tilak-pentapati/Low-Gravity_Rotary-Percussive_Bite-Drilling_System/docs/assets/renders/bit_closeup.png

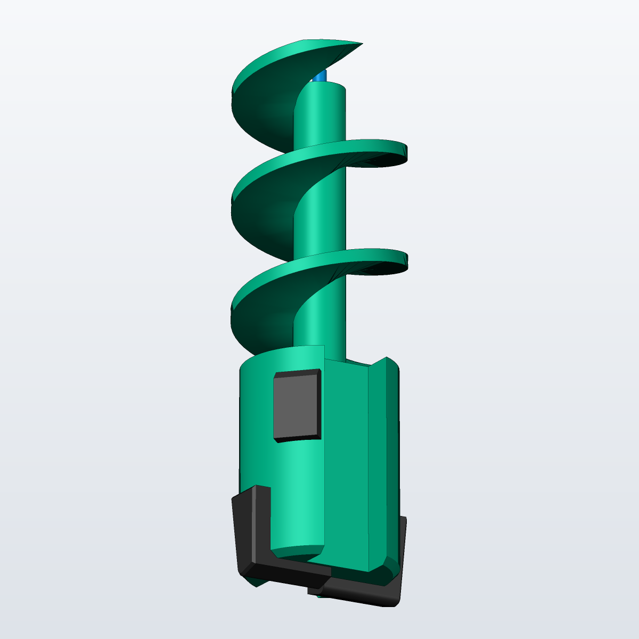
docs/assets/renders/bit_closeup.png
