tilak-pentapati/Low-Gravity_Rotary-Percussive_Bite-Drilling_System/docs/assets/renders/brush_exploded.png

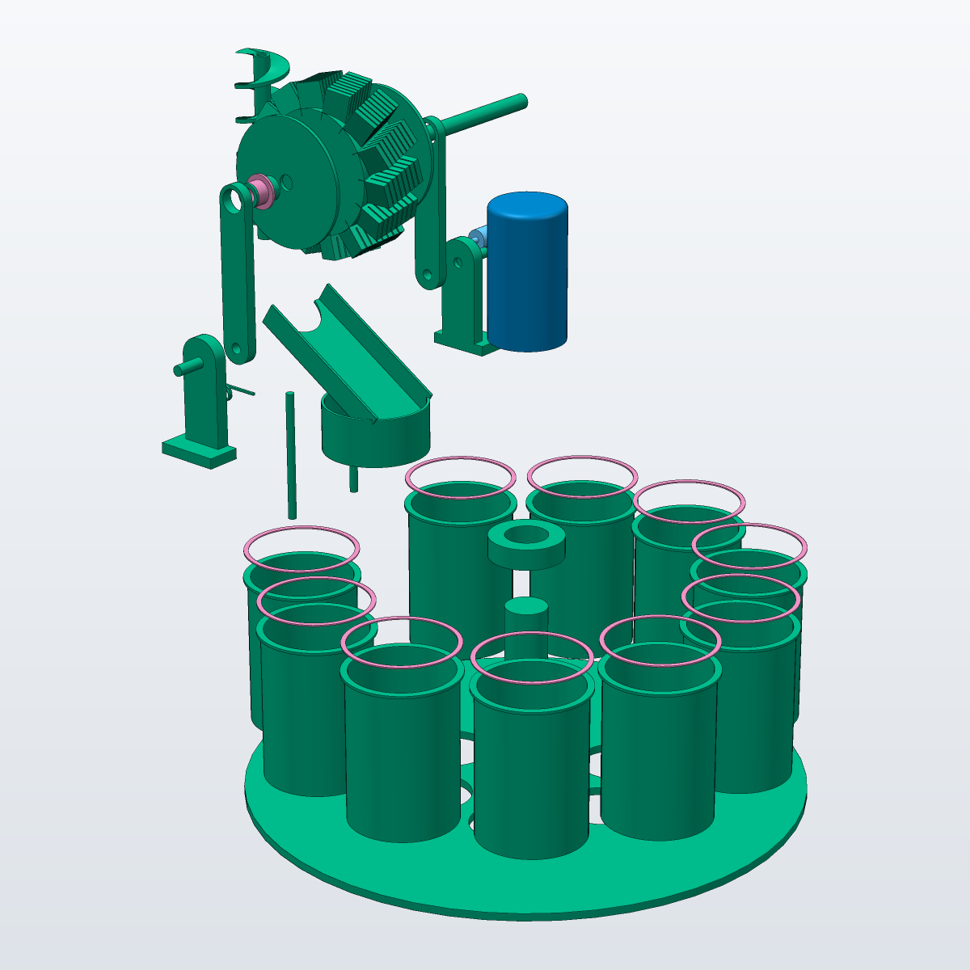
docs/assets/renders/brush_exploded.png
