tilak-pentapati/Low-Gravity_Rotary-Percussive_Bite-Drilling_System/docs/cad_architecture.html

# 3D CAD Architecture & Subassembly Breakdown

Parametric boundary-representation (B-rep) solids, sized by the physics-based design derivations and made interactive in the browser through WebGL, a JavaScript graphics API

Each component on this page is a solid model generated from the system’s design parameters, not drawn by hand. Its dimensions come from the physics-based sizing (loads, stresses, fatigue, vibration and thermal limits), and the browser shows the result as an interactive 3D model.

A boundary representation (B-rep) describes a solid by the surfaces that enclose it. It stores the faces (pieces of planes, cylinders, cones, tori or NURBS surfaces), the edges where faces meet and the vertices where edges meet, together with the topology that records which face borders which [1–3]. Because the boundary is exact, a bearing bore is a true cylinder of a known diameter, and volume, mass, centre of gravity and moments of inertia follow directly from the geometry. A B-rep model is parametric when every dimension is an expression of named inputs, such as auger diameter, flight pitch, bearing size or mast section, instead of a fixed number [4]. When a derivation changes a value (for example the flute depth set by the fatigue check), the solids rebuild with the new value and every dependent dimension follows.

An application programming interface (API) is the set of functions that one piece of software publishes so that other programs can use it. WebGL is such an interface: a JavaScript API, standardised by the Khronos Group, through which a web page sends triangles, material colours and lights to the computer’s graphics processor (GPU) [5]. The viewers on this page use it to draw each model at interactive frame rates in any modern browser, with no plug-in.

The models are published in three file formats, each suited to a different task:

- STEP (ISO 10303-21) is the neutral exchange format for engineering CAD [6]. It carries the exact B-rep geometry, the assembly tree, part names and colours, and it opens in any major CAD package for further design, analysis or manufacture.
- STL stores only a list of flat triangles and their normals, with no units, colours or assembly structure [7]. It is the usual input for 3D printing and for many meshing tools.
- glTF (GL Transmission Format) is the Khronos format for delivering 3D scenes to real-time renderers, and GLB is its single-file binary form [8]. It holds triangle meshes, physically based material properties and a hierarchy of nodes, and it is the format the viewers below load.

## 1 Modelling approach

Every part is modelled once as a parametric B-rep solid by the CAD generator, sized from the same parameter set and design derivations used in the sizing calculations. The same solids are written to colour-labelled, assembly-structured STEP files (mm), tessellated to STL (mm), and tessellated to glTF .glb (m, Y-up) for the viewers below. The web models and the engineering STEP files therefore always match.

Tessellation. The STEP file keeps the exact curved surfaces, but a GPU or a 3D printer can only process flat triangles. Tessellation replaces each curved face by a mesh of triangles whose vertices lie on the true surface, so each triangle edge is a chord across the curve. The error is the chordal deviation, the largest gap between a triangle and the surface it replaces. For a face of radius r divided into segments that each span an angle \theta:

\delta = r\left(1 - \cos\frac{\theta}{2}\right)

- \delta: chordal deviation, the largest distance between the true surface and the triangle that replaces it (mm)
- r: local radius of curvature of the face (mm)
- \theta: angle one segment spans at the centre of curvature (rad)

The generator holds \delta \le 0.08 mm and \theta \le 0.25 rad. On the 10 mm radius of the auger flight, the deviation limit alone would allow \theta = 0.253 rad, so the angular limit governs and a full circle becomes 26 segments. The worst-case error is 0.8 % of the radius, below what a screen can show and below ordinary machining tolerances. Thin, repeated features (helical flights, bristle tufts, coil springs) use coarser limits to keep the files small. The web copy is also converted to the glTF convention of metres with +Y up [8]: a CAD point (x, y, z) in millimetres with Z up becomes (x,\ z,\ -y)\times10^{-3} m. That is a rotation of -90^\circ about the x-axis followed by a scale, so the frame stays right-handed and lengths, angles and the hand of every helix are preserved.

Home pose. The rig is drawn at 1:1 scale in its home pose, the reference configuration from which every motion is measured. In robot-kinematics terms it is the zero position of the prismatic feed joint [9]. The carriage sits at the top of its travel on the rails, so the drill string is fully withdrawn and the bit tip hangs 300 mm above the regolith. That height clears the mast foot plate (100 mm) and the top of the brush (about 223 mm), so the parked bit touches neither the brushing station nor the ground and the load cell reads no weight on bit. To reach the 1.0 m target depth the carriage therefore needs a stroke of 0.30 + 1.00 = 1.30 m. A mission starts and ends here: the controller leaves home, approaches at 5 mm/s until the load cell detects 5 N of contact, and returns to home after the last bite. The digital twin moves the carriage by the displacement \Delta z = z_\text{tip} - z_\text{home} from this pose.

- \Delta z: carriage displacement from the home pose, positive upward (m)
- z_\text{tip}: bit-tip height above the regolith surface at the current instant, negative once the bit is in the hole (m)
- z_\text{home}: bit-tip height in the home pose, 0.30 m

Colour code. The colours carry engineering meaning. Each part is coloured by the job it does in the machine, so a load or energy path can be traced by eye, as in the cutaway drawings of engineering manuals. Finishes are matte, in the manner of technical illustration, so that hue rather than mirror-like highlights carries the information [10]. The eight function hues are the Okabe–Ito colour-universal-design set, chosen so the classes stay distinguishable for readers with colour-vision deficiency, about one man in twelve [11, 12]. Two neutral greys mark the primary structure and the lander. The same colours are written into the STEP part labels, so the code carries into any CAD package.

Colour | Function class | Parts and role
| Rock-cutting interface | Tungsten-carbide inserts and gauge pads: the only parts that touch intact rock
| Seals, bushings & dust control | PTFE / Vespel sliding contacts, lip seals, labyrinths, bellows and wipers that keep regolith out
| Electromechanical conversion & sensing | BLDC motors, encoders, slip ring, load cell, thermocouple path and solar cells
| Percussive (impact) path | Barrel cam, followers, hammer, spring and anvil: stores and releases the blow energy
| Deployment & launch restraint | Hinge, latch, hold-down and release hardware that only works before drilling
| Drill string & sample path | Every part that carries or touches the regolith sample: bit body, auger, brush, chute, cups
| Rotary & linear drive train | Gears, spindle, shafts, bearings, leadscrew, nut and rails that transmit torque and feed force
| Thermal control & energy storage | Avionics warm box, radiator and H2/O2 reactant tanks
| Lander interface (context) | Deck section, legs and footpads that the drill reacts against
| Primary structure | Housings, mast spine, plates, brackets, frames and clamps that carry the loads

Read together, the classes follow the energy through the machine: electrical power is converted in the motors (blue), carried as torque and feed force through the drive train (orange) or stored and released as impact in the percussion path (vermillion), delivered to the rock by the carbide (black), and the reactions return to the lander through the structure (greys). A part’s class follows its role, not its material: the bronze leadscrew nut is orange because it transmits feed force, while the bronze chute is green because it carries the sample.

In every viewer below, drag to orbit, scroll to zoom and right-drag to pan. The tag under each title gives the part count and the overall envelope (width × depth × height). The Download menu offers each model in the three file formats.

### 1.1 Drill bit

#### Crown, sampling sub & joint

11 parts · envelope 21 × 20 × 273 mm

Download

STEPexact B-rep, assembly tree, mmSTLtriangle mesh, mmglTF binary (.glb)web mesh with materials, m

Model failed to load. Serve the site over HTTP; browsers block .glb files opened directly from disk.

#### Exploded view

11 parts · envelope 55 × 42 × 176 mm

Download

STEPexact B-rep, assembly tree, mmSTLtriangle mesh, mmglTF binary (.glb)web mesh with materials, m

Model failed to load. Serve the site over HTTP; browsers block .glb files opened directly from disk.

- Cutters: two WC-10Co chisel inserts, -10° rake / 15° clearance (wedge 85°), edges on the line through the axis so the centre is cut, 2 mm proud of the face. Edge radius 1.00 mm from Hertz contact: carbide FOS 2.08 on a basalt clast, yet 36× the strength of the hardest ice.
- Junk slots: two 8 mm slots ahead of each rake face, sized so their area equals the sampling-flute channel (never the bottleneck). Carbide gauge pads with back-reaming chamfers on the trailing quadrants.
- Indexing: the bit turns 34.6° between hammer blows, so each blow lands 6.3 mm from the last crater at the gauge.
- Sensing & joint: thermocouple pocket ends 0.5 mm above the inserts (carbide conducts the edge heat). M12×1 right-hand joint: drilling torque tightens it, and impact passes through the shoulder (62 MPa), not the thread.
- Exploded view: inserts, gauge pads, thermocouple probe, crown body, sampling sub and coupling pulled apart to show how the bit is built and brazed.

### 1.2 Dual-zone auger string

#### Auger string, bit to hex drive

19 parts · envelope 30 × 20 × 1280 mm

Download

STEPexact B-rep, assembly tree, mmSTLtriangle mesh, mmglTF binary (.glb)web mesh with materials, m

Model failed to load. Serve the site over HTTP; browsers block .glb files opened directly from disk.

- Flights: 20 mm OD over the full length. The upper transport flight runs on a 14/12 mm hollow tube at 39.0 mm pitch (36.1° helix, the screw-efficiency optimum 45° − φ/2).
- Flight attachment: the root carries the stall plug pressure (3.5 MPa, 65 MPa bending) plus an inertial load at every blow's stress-wave front (136 MPa, 3.7e+07 cycles). Fillet welds are strong enough statically, but the weld toe would last only 2.0e+05 cycles (IIW FAT 63), so the flight is machined integral with the tube with a root fillet of t/2: Goodman FOS 2.21.
- String dynamics: a beam model of the 1240 mm string (sampling root, joint, tube, hex) gives a first lateral mode of 46 Hz at the start of the hole (1.77× the blow rate). Without the mast-foot guide bushing (22 mm Vespel liner) it would be 19 Hz, inside the ±20 % resonance band. Buckling 3,294 N vs a 167 N lift-off WOB; first torsional mode 393 Hz; wind-up 13.2° at 6.5 N·m, mostly in the 6 mm sampling root.
- Drive interface: a 16 mm hex sits 52 mm deep in the anvil socket (flank pressure 3.5 MPa, torsion 13 MPa, impact 47 MPa at the pin section). The tube is brazed into the collar (3 mm lap, FOS 19) and its end bears on the socket floor, so the blow never loads the braze. A cross pin (35 MPa at the load-cell rating) carries the hanging string.
- Thermocouple path: a 1 mm type-T lead runs from the bit probe through a spring-loaded coaxial contact at the bit joint (so the bit screws on without twisting it), up the tube and the chamfered hex bore to the slip ring; it fills 6 % of the narrowest bore.

### 1.3 Rotary-percussive drill head

#### Enclosed drill head

68 parts · envelope 220 × 177 × 339 mm

Download

STEPexact B-rep, assembly tree, mmSTLtriangle mesh, mmglTF binary (.glb)web mesh with materials, m

Model failed to load. Serve the site over HTTP; browsers block .glb files opened directly from disk.

#### Quarter section

68 parts · envelope 220 × 177 × 339 mm

Download

STEPexact B-rep, assembly tree, mmSTLtriangle mesh, mmglTF binary (.glb)web mesh with materials, m

Model failed to load. Serve the site over HTTP; browsers block .glb files opened directly from disk.

- Rotary drive: frameless BLDC sized from the 6.5 N·m spindle limit: 0.46 N·m at the rotor gives a Ø31 mm rotor in a Ø54 mm stator. It drives an 8:1 planetary (12/36/84 teeth, 3 planets, module 0.5) and a 12T/24T spur stage (module 1.25). Bending stress is 123 MPa and contact stress 923 MPa, both within AGMA limits for carburised 9310.
- Percussion: a second BLDC drives a 54T ring gear on a two-lobe barrel cam. The cycloidal rise lasts 150°, followed by a 30° dwell, twice the 2.7 ms the hammer takes to fall. The pressure angle peaks at 8.7° and roller contact stress at 528 MPa. The spring is the thinnest stock wire that passes every check: 6.0 mm wire, 3.14 active coils, 360 MPa, fatigue FOS 1.55, surge 682 Hz.
- Load paths: the hammer and anvil both slide on a DIN 5480 spline (flank pressure 4.6 MPa). The 5.4 kN blow travels from hammer to anvil to hex shank and never crosses a bearing. Weight on bit takes a different route: nut, yoke, a 500 N load cell (error 1.2 N, well under the 5 N contact threshold), the housing, the 7004 ACD pair, and the spindle end face. The Tr16×4 screw is self-locking.
- Bearings (SKF catalogue): 7004 ACD pair L10 = 104,061 h, 61804 35,847 h, 61812 cam bearing 18,528 h. The requirement is 400 h, 4× the drilling time. Dust: labyrinth and PTFE lip seal at the spindle exit, a stationary bellows over the 4 mm anvil float, and rail wipers on the LM16UU bushings.
- Quarter section: the housing and the coaxial stack are cut away in one quadrant. From the bottom up: anvil with hex socket, hammer with follower rollers on the barrel cam, spring, 7004 bearing pair, slip ring, 61804 bearing, 24T gear, then the planetary and motor in the offset pod, the load cell and the yoke.

### 1.4 Deployable mast and lander interface

#### Deployed, on the lander deck

118 parts · envelope 1260 × 2249 × 1977 mm

Download

STEPexact B-rep, assembly tree, mmSTLtriangle mesh, mmglTF binary (.glb)web mesh with materials, m

Model failed to load. Serve the site over HTTP; browsers block .glb files opened directly from disk.

#### Launch configuration (stowed)

205 parts · envelope 1260 × 2696 × 884 mm

Download

STEPexact B-rep, assembly tree, mmSTLtriangle mesh, mmglTF binary (.glb)web mesh with materials, m

Model failed to load. Serve the site over HTTP; browsers block .glb files opened directly from disk.

- Architecture: the drill rides on the fore edge of a 0.6 × 1.5 m lander deck section. It launches folded aft over the deck; a strain-wave hinge actuator swings it 90° to vertical, where spring latch pins on two deck posts lock it 250 mm above the hinge. Sequence: SMA hold-down release → carriage to home → deploy → latch → release the brush arm.
- Spine: 80×80×3 mm 6061-T6 Al box, the lightest of 240 (material, section, bracket count, latch height) combinations that passes every check (64 pass the deployed ones). Deployed first mode 20.0–21.2 Hz over the drilling stroke: between the cam (13 Hz) and blow (26 Hz) bands with ≥20% separation, 2% from the nearest band edge. Spine 5.4 kg, rotating assembly 24.9 kg incl. 20% growth allowance. The spine is in tension while drilling; buckling matters only when pulling a stuck string (FOS 218).
- Rails & alignment: 4 brackets support the Ø16 rails every 357 mm; their necks pass the slot of open LM16UU-OP bushings. An end-supported rail would be a 10 Hz string at launch. Under the 167 N lift-off WOB plus a 619 N single-cutter side load, spine bending, slope and rail flex move the string 0.49 mm off the guide-bushing axis (clearance 0.5 mm): a 3.7 mm bit alignment error at 1 m.
- Leadscrew: buckling 2,005 N on the compression side (FOS 12); whirl critical speed 558 rpm, with retraction at 34% of it (limit 80 %). The self-locking Tr16×4 nut holds the carriage at launch (3.5 MPa).
- Hinge, latch & actuator: Ø6 mm 17-4PH pins in double shear at a 14.5 kN launch lug load (FOS 2.4). Deploying needs 53 N·m against Mars gravity with the mast horizontal. ECSS motorisation (2× gravity, friction and harness + 1.25× inertia) gives 108 N·m, a Ø48 mm rotor through a 100:1 strain-wave gear. Earth tests need a g-offload. The latch is sized by stiffness (647 N per pin).
- Lander tilt: a side-mounted drill pushes up 0.35 m from the lander CG, so the near legs unload at 0.82 m g, before the lander lifts. The set-point stays m g / 1.4. The far legs sit 1.94 m behind the drill so the tilt limit (60 N Moon, 137 N Mars) stays above the set-point plus the load-cell error. The tilt margin is 1.15, against 1.4 for a drill through the CG. Footpad friction alone reacts the torque limit (FOS 2.4 on the Moon), so no regolith anchors are needed.
- Stow pose: the carriage parks 701 mm below home, chosen to maximise the weakest local mode. The nut then splits the leadscrew (22 Hz) and the guide bushing props the string (23 Hz); left at home both would be ~10 Hz. At 15 g (GEVS Miles 3σ) the screw sees 124 MPa and the string 200 MPa.
- Stowed primary mode: 97 Hz on the hinge plus 2 hold-downs (requirement 50 Hz; a single hold-down at the crosshead would give 45 Hz with this spine). Launch loads are the larger of 15 g quasi-static and the Miles 3σ response; spine stress 47 MPa (yield FOS 5.1).
- Hold-downs: pyro-free SMA-released A-286 M8 frangible bolts in cup-cone pedestals. They carry 6.6 kN at launch, and the preload keeps the joint closed with NASA-STD-5020 separation and ultimate factors. The cones carry shear, the hinge carries load along the mast, and the actuator gearbox carries none.

### 1.5 Brushing station and sample carousel

#### Brushing station, exploded

60 parts · envelope 210 × 239 × 255 mm

Download

STEPexact B-rep, assembly tree, mmSTLtriangle mesh, mmglTF binary (.glb)web mesh with materials, m

Model failed to load. Serve the site over HTTP; browsers block .glb files opened directly from disk.

- Brush as a worm wheel: the sampling flight is a single-start worm, and the 14 bristle tufts are the wheel teeth on a 29.0 mm pitch radius (35.5 mm from the auger axis), leaning 17.7° at the flight lead. The tuft count is the smallest that enters and leaves the flute without touching a flight and still leaves a 1 mm hub ligament. The brush turns one tuft per auger revolution. The 39 mm transport pitch is exactly 3× the sampling pitch, so the transport flight meshes too.
- Bristles: 0.10 mm 17-7PH wire, tips 0.2 mm past the flute root. Their tip pressure is 59 kPa, 13× the cuttings' Rankine passive pressure, at 72 MPa (Goodman FOS 12.8). Thicker wire would wear longer, but with the bit above the guide bushing the string is a 1.24 m cantilever. The total contact force (0.36 N) must stay under the 0.44 N that would push the bit past the bushing lead-in.
- Drag & mission: derived drag 2.9 mN·m with full flutes (plough + bristle friction + bushings), 0.67 mN·m on empty flights. Both feed the state machine. The root-contact patch sets the sweep speed to 2.6 mm/s (87 s per bite).
- Spring-loaded arm: two 55 mm arms hang from pivot pins below the axle, so the line-of-centres force acts at 90° to them and the arm load does not depend on gravity. The arm floats on the bristles: a 0.8 mm torsion spring, wound up 14°, preloads it with exactly the required bristle force (0.36 N). When the bit crown's gauge step passes, the force rises only 3.7 %. The axle runs in Vespel SP-3 bushings (PV 9 Pa·m/s, far below the limit).
- Chute & cup: one bite gives 52 cm³ of bulked cuttings. The bronze chute is pitched at 32°, 10° steeper than the cuttings-on-bronze friction angle, and its inlet wraps the auger at the bit's largest re-entry excursion. The lunar flow layer is only 0.2 mm deep. A bronze funnel carries the stream through a port in the mast foot plate into that bite's cup.
- Sample carousel: each bite gets its own cup. The 10 cups (Ø37.8 mm × 55.5 mm, 120 % of one bite) hang on a turntable under the foot plate, on a 82 mm pitch radius with one blank station (11 stations). The cups are as deep as the ground clearance allows, which keeps the bore and the carousel small. The plate is their lid: PTFE face seals on every rim bear on its underside, and only the cup under the port is open. A stepper with a planetary gearhead on the plate indexes one station in 6 s while the auger descends for the next bite, so indexing adds no mission time. With every cup full, ECSS motorisation needs 0.31 N·m, most of it seal drag, against 0.70 N·m rated, at 0.07 W. The carousel adds 0.82 kg to the mast foot, which the mast frequency, hold-down and deployment sizing above already include.
- Planetary protection: the arm swings 13° to a stowed position that a launch lock holds through launch and the pre-flight dry-heat bake-out, with the tips clear of the bit. Every brush-station material (17-4PH, 17-7PH, phosphor bronze, Vespel, Ti) tolerates the bake-out temperature. Open risk: a thin layer of cohesive fines may still cling to the chute in lunar gravity. Every cup except the one being filled stays sealed, and the blank station keeps all ten sealed through launch, bake-out and after the last bite, which limits cross-contamination between samples.

### 1.6 Power system

#### Sun-tracking wings and energy storage

81 parts · envelope 3593 × 828 × 1822 mm

Download

STEPexact B-rep, assembly tree, mmSTLtriangle mesh, mmglTF binary (.glb)web mesh with materials, m

Model failed to load. Serve the site over HTTP; browsers block .glb files opened directly from disk.

- Solar (selected by trade study): two 2-axis sun-tracking wings, each two 0.68 m² GaInP/GaAs/Ge panels (800 × 1700 mm), on azimuth turntables at the ends of deck outriggers 2.68 m apart at the lander CG station (derived so a wing tilted to the steepest Mars sun clears the legs), with an elevation yoke through each wing centre. Tracking gives about 2.8× the output of fixed vertical panels at the lunar pole.
- Storage & avionics: Kapton-wrapped warm box with top radiator, plus four clamped H2/O2 reactant tanks for the 1375 Wh store (see the storage trade on the Derivations & Design page).

## 2 Integrated drill rig and kinematic structure

#### Complete drill rig, home pose

286 parts · envelope 3593 × 2249 × 2222 mm

Download

STEPexact B-rep, assembly tree, mmSTLtriangle mesh, mmglTF binary (.glb)web mesh with materials, m

Model failed to load. Serve the site over HTTP; browsers block .glb files opened directly from disk.

The complete assembly brings every subassembly above onto the lander at its true position. It is stored as a scene graph: a tree of nodes, each holding a coordinate frame (a position and an orientation relative to its parent node) and the parts attached to that frame [13]. A node inherits every motion of its parent and adds its own. A part’s pose in the world is therefore the product of the transforms along the path from the root of the tree to the node that holds it:

\mathbf{T}_\text{world} = \mathbf{T}_1\,\mathbf{T}_2 \cdots \mathbf{T}_n

- \mathbf{T}_\text{world}: 4\times4 homogeneous transform giving the part’s position (m) and orientation in the world frame
- \mathbf{T}_1 \ldots \mathbf{T}_n: transform of each node relative to its parent, from the root (1) down to the node that holds the part (n); each combines a 3\times3 rotation and a translation (m)

This is the forward-kinematics rule used for serial robot arms [9]. The tree follows the physical joints of the machine: parts that are bolted together share one node, because a rigid body has a single pose, and a new node starts wherever a joint lets one group move relative to another. The solar wings show the nesting most clearly. Each elevation node is the child of an azimuth node, which is the child of the static power-system node, so turning a turntable carries the yoke and panels round with it, and the elevation tilt is then applied in the turned frame, exactly as in a two-axis gimbal. The drill-head nodes (carriage, auger, hammer, cam) sit side by side under the root and receive the same feed displacement, which is equivalent to a rigid attachment to the carriage. With this structure, one number per joint is enough to pose the whole machine.

The numbers come from state-machine telemetry. The drill’s autonomy software is a finite-state machine: at every instant it is in exactly one of six states (IDLE, ACTIVE, SEARCH, DRILL, RETRACTION, TRANSFER) and it moves to another only when a defined physical condition is met [14]. For example, SEARCH becomes DRILL when the load cell reads the contact force, and DRILL becomes RETRACTION when the bite reaches its length or when a temperature or torque limit trips. The mission simulation steps this machine forward once per second, solving the cutting mechanics, the bit’s heat balance and the sun geometry at each step. It records the result as telemetry, a time series of 29 columns that include bit-tip depth, weight on bit, spindle speed and torque, percussion duty, bit temperature, sun azimuth and elevation, and carousel station. The digital twin on the Results & Digital Twin page [15] reads this record and turns each channel into a joint coordinate: depth sets the carriage translation, spindle speed is integrated over time into the auger’s spin angle, the sun angles set the wing gimbals and the bite counter sets the carousel index. The animation is therefore a replay of what the simulated controller did, not a scripted sequence.

glTF node | Parts | Contents | Motion in the digital twin
Frame_Node | 76 | Lander Deck Panel, Deck Face Sheet, Hinge Tongue L, Hinge Pin L, Hinge Tongue R, Hinge Pin R … | Static. Lander deck, legs, hinge, latch posts and the deployed mast, latched on its posts.
Solar_Node | 25 | H2O2 Reactant Tank 1, Tank 1 Clamp 1, Tank 1 Clamp 2, H2O2 Reactant Tank 2, Tank 2 Clamp 1, Tank 2 Clamp 2 … | Static. Tanks, warm box, outriggers and turntable housings.
Carriage_Node | 56 | Cam Bearing 61812 Rings, Cam Bearing 61812 Balls, Cam Bearing Spigot, Percussive Pinion 18T, Percussive BLDC Stator, Percussive BLDC End Turns … | Vertical translation along the rails: 1.30 m stroke (home → 1.0 m bit depth).
Auger_Node | 24 | WC Insert 1, WC Insert 2, Bit Crown Body, Gauge Reamer Pad 1, Gauge Reamer Pad 2, Thermocouple Probe … | Same translation as the carriage, plus spin about the auger axis at the commanded RPM.
Hammer_Cam_Node | 5 | Hammer Mass, Cam Follower Stud 1, Cam Follower Roller 1, Cam Follower Stud 2, Cam Follower Roller 2 | Carriage translation, plus spindle rotation (splined hammer) and a 26 Hz cam-lift / drop stroke while percussing.
Cam_Ring_Node | 2 | Barrel Cam Ring Gear, Barrel Cam Track 2 Lobe | Carriage translation, plus barrel-cam spin while percussing.
Brush_Gear_Node | 20 | Brush Axle, Brush Hub, Bristle Tuft 01, Bristle Tuft 02, Bristle Tuft 03, Bristle Tuft 04 … | Worm-wheel spin about its own axle: one tuft per auger revolution (14:1), plus the axial auger speed over the 29 mm pitch radius.
Carousel_Node | 22 | Carousel Turntable, Carousel Hub, Sample Cup 01, Cup Seal Ring 01, Sample Cup 02, Cup Seal Ring 02 … | Index rotation about the carousel axis under the foot plate: one station (32.7°) per bite, so bite n always fills cup n.
Solar_Wing_Port_Az_Node | 9 | Port Azimuth Platter, Port Mast Post, Port Post Foot, Port Yoke Crossbar, Port Yoke Arm 1, Port Elevation Bearing 1 … | Azimuth rotation about the turntable axis, following the computed sun azimuth.
Solar_Wing_Port_Elev_Node | 19 | Port Panel Upper Substrate, Port Panel Upper GaInP Cells, Port Panel Upper Busbar 1, Port Panel Upper Busbar 2, Port Panel Upper Busbar 3, Port Panel Upper Busbar 4 … | Elevation tilt about the yoke axis, so the cell normal follows the sun elevation.
Solar_Wing_Starboard_Az_Node | 9 | Starboard Azimuth Platter, Starboard Mast Post, Starboard Post Foot, Starboard Yoke Crossbar, Starboard Yoke Arm 1, Starboard Elevation Bearing 1 … | As port.
Solar_Wing_Starboard_Elev_Node | 19 | Starboard Panel Upper Substrate, Starboard Panel Upper GaInP Cells, Starboard Panel Upper Busbar 1, Starboard Panel Upper Busbar 2, Starboard Panel Upper Busbar 3, Starboard Panel Upper Busbar 4 … | As port.

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

\omega_b = \frac{1}{r_p}\left(\frac{\omega_a\,p}{2\pi} + v_z\right)

- \omega_b: angular speed of the brush (rad/s)
- r_p: pitch radius of the brush tufts, 29.0 mm
- \omega_a: angular speed of the auger (rad/s)
- p: lead of the flight passing the brush, 13.0 mm in the sampling zone and 39.0 mm in the transport zone
- v_z: axial speed of the string past the brush (m/s)

This split between independent and dependent motions is why the controller needs only eight commanded set-points to pose a 286-part machine. The barrel cam’s spin is drawn at a reduced rate so it stays readable. The hammer stroke is drawn at the true blow rate of 26 Hz, which a 60 Hz display can only just resolve: about 2.3 frames per blow, against the minimum of two samples per cycle set by the sampling theorem [16].

## References

[1]

A. A. G. Requicha, “Representations for rigid solids: Theory, methods, and systems,” ACM Computing Surveys, vol. 12, no. 4, pp. 437–464, 1980.

[2]

I. Stroud, Boundary representation modelling techniques, Springer, 2006.

[3]

L. Piegl and W. Tiller, The NURBS book, 2 ed., Springer, 1997.

[4]

J. J. Shah and M. Mäntylä, Parametric and feature-based CAD/CAM: Concepts, techniques, and applications, John Wiley & Sons, 1995.

[5]

The Khronos Group, “WebGL 2.0 specification,” https://registry.khronos.org/webgl/specs/latest/2.0/, 2017.

[6]

International Organization for Standardization, ISO 10303-21:2016 industrial automation systems and integration – product data representation and exchange – part 21: Implementation methods: Clear text encoding of the exchange structure, 2016.

[7]

3D Systems, Inc., “StereoLithography interface specification,” 3D Systems, Inc., Valencia, CA, 1988.

[8]

The Khronos Group, “glTF 2.0 specification (also published as ISO/IEC 12113:2022),” https://registry.khronos.org/glTF/specs/2.0/glTF-2.0.html, 2021.

[9]

J. J. Craig, Introduction to robotics: Mechanics and control, 3 ed., Pearson Prentice Hall, 2005.

[10]

A. Gooch, B. Gooch, P. Shirley, and E. Cohen, “A non-photorealistic lighting model for automatic technical illustration,” in Proceedings of the 25th annual conference on computer graphics and interactive techniques (SIGGRAPH ’98), pp. 447–452, 1998.

[11]

M. Okabe and K. Ito, “Color universal design (CUD): How to make figures and presentations that are friendly to colorblind people,” J*Fly, https://jfly.uni-koeln.de/color/, 2008.

[12]

B. Wong, “Points of view: Color blindness,” Nature Methods, vol. 8, no. 6, pp. 441, 2011.

[13]

J. D. Foley, A. van Dam, S. K. Feiner, and J. F. Hughes, Computer graphics: Principles and practice, 2 ed., Addison-Wesley, 1990.

[14]

D. Harel, “Statecharts: A visual formalism for complex systems,” Science of Computer Programming, vol. 8, no. 3, pp. 231–274, 1987.

[15]

M. Grieves and J. Vickers, “Digital twin: Mitigating unpredictable, undesirable emergent behavior in complex systems,” in Transdisciplinary perspectives on complex systems, pp. 85–113, Springer, 2017.

[16]

C. E. Shannon, “Communication in the presence of noise,” Proceedings of the IRE, vol. 37, no. 1, pp. 10–21, 1949.

Autonomous Low-Gravity Rotary-Percussive Bite-Drilling System (MBSE Digital Twin)

CAD models generated in code with the help of Claude (Anthropic)
