tilak-pentapati/Low-Gravity_Rotary-Percussive_Bite-Drilling_System/docs/theory_and_sizing.html

# Terramechanics, Design Derivations & Power Sizing

Each dimension and power figure on this page is solved from force, energy and heat balances, using the measured gravity and ground properties of the Moon and Mars

Terramechanics is the mechanics of soil and granular ground under the loads applied by a machine: how the ground deforms, shears and fails when a wheel, blade or cutter is pressed into it [1]. For a drill, the ground is lunar or Martian regolith, which may be cemented by water ice. Its resistance to cutting is set by its cohesion, internal friction and ice content. Design derivations take that resistance and apply Newton’s laws, conservation of energy, stress-wave mechanics and fatigue theory to fix each dimension of the drill: the bit load, the hammer, the auger flutes. Power sizing closes the energy balance. The electrical energy the drill consumes must be supplied by the solar array, with the battery covering any shortfall, at the solar flux and gravity of each body.

## 1 Method

The model is built in three layers, so every result can be traced back to a stated assumption:

1. Primary inputs. Each value carries a tag:
  - [ENV]: an environment fact, with its source (gravity, temperature, ground strength).
  - [DES]: a design choice, with its rationale.
  - [COEF]: an empirical coefficient from the literature, with its plausible range.
  - [CRIT]: an acceptance criterion or a factor of safety.
2. Derivations turn those inputs into sizes and limits. All of them are listed in the derivation table at the bottom of this page.
3. Simulation integrates the drilling mission second by second with those sizes. No factor is adjusted afterwards to reach a desired result.

An acceptance criterion is a physical limit that a computed quantity must satisfy for the design to be accepted. Examples are a bit temperature below the point where ice is lost, or a bit load below the load that would lift the lander. A factor of safety (FOS) is the ratio of the capacity of a part to the demand placed on it:

FOS = \frac{\text{capacity}}{\text{demand}} \;\; \left(\text{e.g. } \frac{S_y}{\sigma} \text{ for strength}\right)

where

- S_y: yield strength of the material, the stress at which it starts to deform permanently (Pa)
- \sigma: largest stress the part carries in service (Pa)

A design with FOS > 1 can carry its load. The margin above 1 covers uncertainty in the loads, the material properties and the model itself. Spaceflight structures use factors of 1.25–1.4 on ultimate strength [2]. Parts under repeated load, such as the auger under hammer blows, are checked against fatigue strength instead [3].

## 2 Environments and stratigraphy

Astronomical object | Layer | Depth (m) | UCS, σc (kPa) | Ice content (wt %) | Thermal conductivity, k (W/(m·K))
Moon | Surficial Regolith Fluff (desiccated) | 0.00–0.20 | 2.1 | 0 | 0.002
Moon | Compacted Dry Regolith | 0.20–0.50 | 7.4 | 0 | 0.01
Moon | Low-Ice Cemented Regolith (~3 wt%) | 0.50–0.80 | 5 000 | 3 | 0.3
Moon | Icy Regolith (~8 wt%) | 0.80–1.00 | 20 000 | 8 | 0.8
Mars | Dry Soil above the Ice Table | 0.00–0.05 | 2.5 | 0 | 0.085
Mars | Pore-Ice Cemented Ground (ICG) | 0.05–0.50 | 18 000 | 20 | 1.5
Mars | Dense Ice-Cemented Ground | 0.50–0.80 | 22 000 | 25 | 1.8
Mars | Excess (Nearly Pure) Ground Ice | 0.80–1.00 | 12 000 | 90 | 3.0

UCS (unconfined, or uniaxial, compressive strength), \sigma_c, is the axial stress at which a sample of the ground fails when it is compressed along one axis with no side support. It is measured in pascals (1 kPa = 10³ Pa, 1 MPa = 10⁶ Pa) and sets how hard the ground is to cut. Dry regolith fails at a few kPa. Ice-cemented ground fails at tens of MPa, about four orders of magnitude higher. Thermal conductivity, k, is the rate of heat flow through a 1 m thick layer of 1 m² area per kelvin of temperature difference across it. Its unit is the watt per metre-kelvin, written W/(m·K) or W m⁻¹ K⁻¹. It controls how fast the drill bit can shed its frictional heat into the ground. Ice content is the mass of water ice per unit mass of the ground, in weight percent.

The dry layers have no ice to bind the grains, so their strength comes only from cohesion and friction. Their UCS follows from the Mohr–Coulomb failure criterion under uniaxial load [4, 5]:

\sigma_c = 2c\tan\!\left(45^\circ + \frac{\phi}{2}\right)

where

- \sigma_c: unconfined compressive strength (Pa)
- c: cohesion, the shear strength of the ground at zero normal stress (Pa)
- \phi: angle of internal friction, which sets how shear strength grows with normal stress (°)

Cohesion and friction angle come from [6] (Moon) and [7] (Mars). The icy-layer strengths follow published trends for ice-cemented regolith [8, 9]. Thermal conductivities come from [6] and from the Phoenix probe measurements [10]. The Moon site is an ice-stable area near the Shackleton rim with a subsurface temperature of about 100 K [11]. The Mars site is the Phoenix landing area at 68°N, where the ice table sits about 5 cm down [12, 13].

These are representative values for each site. Every design parameter below is a function of these ground properties (\sigma_c, \phi, c, k and ice content). If a site is characterised more closely, the same equations return new sizes. No one has drilled to 1 m at either site, so the properties are inferred in stages. Each stage uses a physical signal that reaches below the surface:

- Neutron spectroscopy from orbit. Cosmic rays knock neutrons out of the top metre of ground. Hydrogen nuclei have nearly the same mass as a neutron, so they slow neutrons far more efficiently than heavier nuclei do. A drop in the epithermal neutron flux therefore marks hydrogen, most likely water ice, in the upper ~1 m. This mapped polar hydrogen on the Moon [14] and the ice-rich layer below a dry cover at high Martian latitudes [15].
- Thermal infrared radiometry. Measured surface temperatures, together with a heat-conduction model, give the depth below which ice is stable against sublimation. This is how the cold traps near the lunar south pole were identified [11].
- Reflectance spectra and impacts. Water ice absorbs near-infrared light at known wavelengths, which revealed exposed ice in shadowed lunar craters [16]. The LCROSS impactor threw up ejecta from a shadowed crater, and the water was measured directly in the plume [17]. On Mars, steep eroding scarps expose buried ice sheets in cross-section to high-resolution cameras [18].
- In-situ contact. Landers measure strength directly. Apollo core tubes and penetrometers gave lunar density and cohesion [6]. Phoenix’s scoop found hard ice-cemented ground a few centimetres down [7, 13]. The InSight heat-flow probe stalled at about 40 cm in unexpectedly cohesive soil, which shows how far orbital estimates can be from the true ground [19].
- The drill as a sensor. While drilling, the measured torque, bit load and penetration rate give the energy spent per unit volume of rock removed. That energy tracks the ground’s compressive strength [20]. The drill therefore measures UCS layer by layer as it advances, as the Icebreaker field tests showed [21].

## 3 Weight-on-bit limit

Weight on bit (WOB) is the axial force pressing the bit into the ground. The drill pushes against the lander, so the lander’s weight is the only reaction force available. The bit load must stay below the load that would lift the lander, with a margin:

WOB_{\lim} = m g, \qquad WOB_{set} = \frac{m g}{FOS}, \quad FOS = 1.4

where

- WOB_{\lim}: lift-off limit, the bit load that would just lift the lander off the ground (N)
- WOB_{set}: set-point, the bit load the feed controller holds while drilling (N)
- m: deployed lander mass reacting the bit load, 45 kg
- g: surface gravity, 1.62 m/s² (Moon) and 3.71 m/s² (Mars)
- FOS: factor of safety on lift-off (dimensionless)

The factor of 1.4 follows NASA-STD-5001 practice for ultimate loads [2].

Astronomical object | Lift-off limit, WOBlim (N) | Set-point, WOBset (N)
Moon | 72.9 | 52.1
Mars | 166.9 | 119.2

## 4 Rotary cutting and its stall in icy ground under lunar gravity

The model is the drag-bit law of [22]. Rounded cutter edges behave as wear-flats of total length \ell, carrying a load W_f = \sigma\,\ell\,a before any cutting happens:

\delta = \frac{W - W_f}{\zeta\, a\, \varepsilon}\;(\le \text{cutter protrusion}), \quad T = \tfrac12 a^2\varepsilon\delta + \tfrac12\mu a W_f, \quad ROP_{rot} = \delta\,\frac{N}{60}

where

- \delta: depth of cut per revolution of the bit (m)
- W: weight on bit, the applied axial load (N)
- W_f: threshold load carried by the wear-flats in contact with the ground before the cutters bite (N)
- \sigma: contact stress under the wear-flats (Pa)
- \ell: total wear-flat length of all cutters (m)
- a: bit radius (m)
- \zeta: ratio of normal to tangential cutting force on a cutter (dimensionless)
- \varepsilon: intrinsic specific energy, the energy needed to cut a unit volume of ground (J/m³ = Pa)
- T: torque on the bit (N·m)
- \mu: friction coefficient under the wear-flats (dimensionless)
- ROP_{rot}: rate of penetration by rotary cutting alone (m/s)
- N: rotary speed (rev/min)

The values used are \varepsilon \approx \sigma \approx \sigma_c [23], \zeta = 0.6, a = 10.5 mm and \ell = 0.66 mm. In the icy layers W_f reaches about 139 N, far above the lunar set-point of 52 N. The rotary depth of cut therefore drops to zero there, and percussion has to do the work.

## 5 Percussion: the cam-spring hammer

The two-lobe barrel cam compresses the spring by the cam lift h and then releases the hammer onto the anvil:

E = \tfrac12 k_s h^2, \quad v = \sqrt{2E/m_h}, \quad F = v\frac{Z_h Z_r}{Z_h + Z_r}\;(Z = \rho c A), \quad W_{\min} = m_h v (1+e) f

where

- E: blow energy, the spring energy released per blow (J)
- k_s: spring stiffness (N/m)
- h: cam lift, the spring compression per blow (m)
- v: hammer speed at impact (m/s)
- m_h: hammer mass (kg)
- F: peak impact force carried into the drill rod (N)
- Z_h, Z_r: mechanical impedance of the hammer and of the rod (N·s/m)
- \rho: material density (kg/m³)
- c: longitudinal stress-wave speed in the material (m/s)
- A: cross-sectional area (m²)
- W_{\min}: smallest bit load that keeps the bit seated against the rebound of each blow (N)
- e: coefficient of restitution of the impact (dimensionless, 0 to 1)
- f: blow frequency (Hz)

Penetration follows from an energy balance using the percussive specific energy SE_p = c_p\,\sigma_c and the transfer efficiency \eta_t [20, 24, 25]:

ROP_{perc} = \frac{\eta_t E f}{A_{hole}\, SE_p}

where

- ROP_{perc}: rate of penetration by percussion (m/s)
- \eta_t: fraction of the blow energy transferred into breaking the ground (dimensionless)
- A_{hole}: cross-sectional area of the hole (m²)
- SE_p: percussive specific energy, the blow energy needed per unit volume of ground broken (J/m³ = Pa)
- c_p: ratio of percussive specific energy to UCS (dimensionless)
- \sigma_c: unconfined compressive strength of the layer (Pa)

Quantity (unit) | Symbol | Value | Origin of the value | Acceptance limit
Blow energy (J) | E | 2.25 | E = ½ ks h², ks = 125 kN/m, h = 6 mm | –
Blow frequency (Hz) | f | 26 | 2 cam lobes × 13 rev/s | –
Hammer mass (kg) | mh | 0.379 | volume × density of the CAD hammer ring | –
Impact speed (m/s) | v | 3.45 | v = √(2E / mh) | –
Peak impact force (N) | F | 5417 | 1-D stress-wave impedance, Z = ρcA | –
Spring natural frequency (Hz) | fn | 91.4 | fn = √(ks / mh) / 2π | > 2f = 52
Minimum WOB to stay seated (N) | Wmin | 44.1 | Wmin = mh v (1 + e) f | < Moon set-point 52.1
Spring shear stress (MPa) | τ | 360 | Wahl-corrected coil shear stress at full lift | < 690 (allowable)
Electrical power (W) | Pe | 76.5 | Pe = E f / (ηm ηcam), ηm ηcam = 0.765 | –

The table lists the hammer as designed. The first six rows follow in sequence from the equations above. The spring stiffness and cam lift fix the blow energy. The hammer mass, taken from the CAD part, then fixes the impact speed, and the impedances of the hammer and rod fix the peak force. The blow frequency is the number of cam lobes times the cam speed. The last column gives the acceptance limit each derived value is compared against. A dash means the row is an input or an intermediate value with no limit of its own. Three limits apply:

- The spring natural frequency (91 Hz) must be more than twice the blow frequency (52 Hz). The spring can then push the hammer back onto the cam before the next lobe arrives.
- The bit load needed to absorb the rebound of each blow (44.1 N) must stay below the lunar set-point (52.1 N). Otherwise the bit would bounce off the hole bottom. The margin is narrow, about 18 %. On Mars the set-point is more than twice as high.
- The coil shear stress (360 MPa) must stay below the 690 MPa allowable for the spring steel [3].

All three limits are met. The electrical power is the mechanical blow power E f divided by the motor and cam efficiencies.

## 6 Auger design derivations

Flute depth (strength). Every blow sends a compressive stress wave down the auger while the motor applies up to 6.5 N·m of torque. The root is the weakest section. A Goodman fatigue check with FOS 1.5 on 17-4PH steel [3] selects the smallest root that survives. The chart sweeps the candidate flute depths.

Derived quantity (unit) | Value | Governing relation
Sampling flute depth (mm) | 7.0 (root diameter 6.0) | deepest flute with Goodman FOS ≥ 1.5
Sampling pitch (mm) | 13.0 | tan α ≤ μflight: cuttings stay on a stopped flight
Sampling length (mm) | 225 | holds one bite of bulked cuttings × 1.2
Flute capacity, choking onset (cm of hole) | 12.25 | zcrit = Ls Aflute / (Ahole B)
Transport helix angle (°) / pitch (mm) | 36.1 / 39.0 | α* = 45° − φf/2 (maximum screw efficiency)
Conveying lift ratio at 150 rpm (dimensionless) | Moon 0.64, Mars 0.279 | μw ω² r / g; ≥ 1 needs > 188 / 284 rpm
Brush sweep speed (mm/s) / transfer time (s) | 2.61 / 87 | 3 brush passes per flute point

The table lists the auger geometry, each row fixed by the relation in the right-hand column:

- Flute depth. The sampling flute is cut as deep as the fatigue check allows, 7.0 mm, leaving a 6.0 mm root. Deeper flutes hold more cuttings.
- Pitch. The flight’s helix angle α at the mean radius is kept below the friction angle of cuttings on steel (μflight = 0.32, i.e. 17.7°). Cuttings resting on a stopped flight therefore do not slide back down. This gives a 13.0 mm pitch.
- Sampling length. The fluted length L_s must hold the cuttings of one 10 cm bite after they bulk up by the factor B = 1.5 on loosening, plus 20 %.
- Choking onset. The flute capacity z_{crit} is the hole depth whose bulked cuttings exactly fill the flutes: 12.2 cm, above the 10 cm bite.
- Transport flute. The helix angle α* = 45° − φf/2 maximises the efficiency of a screw that pushes material [3].
- Conveying. The lift ratio compares the friction force that wall contact can generate at the auger’s spin speed with the weight of the cuttings. Below 1, a spinning auger cannot lift cuttings continuously up the hole.
- Brushing. The last row is the brush speed and the time to clear the sampling flutes after each bite.

Here \mu_w is the cuttings-on-wall friction coefficient (dimensionless), \omega the auger angular speed (rad/s), r the auger radius (m), g the surface gravity (m/s²), A_{flute} and A_{hole} the flute and hole cross-sections (m²), and \phi_f the friction angle of cuttings on the flight (°).

The conveying check is the physical reason for bite-drilling. At a safe speed, wall friction from the spinning auger cannot lift cuttings against gravity on either body. The cuttings therefore stay in the deep sampling flutes until the auger is withdrawn and brushed, and the 10 cm bite has to fit inside the flute capacity.

### 6.1 Choking beyond the flute capacity

Once a bite exceeds z_{crit}, the surplus cuttings are pushed up the narrow transport flute as a compacted plug. The plug’s resistance grows exponentially with its length (Janssen, as for a plug pushed up a tube) [26]:

\sigma(L) = \sigma_0 \exp\!\left(\frac{4\mu_w K L}{D_h}\right), \quad K = 1-\sin\phi, \quad T = \sigma A\, r_m \tan(\alpha + \phi_f)

where

- \sigma(L): axial stress needed to push a plug of length L (Pa)
- \sigma_0: axial stress at the free end of the plug (Pa)
- \mu_w: friction coefficient between the cuttings and the hole wall (dimensionless)
- K: ratio of lateral to axial stress in the plug (dimensionless)
- L: plug length (m)
- D_h: hydraulic diameter of the transport flute, 4 × area / wetted perimeter (m)
- \phi: internal friction angle of the cuttings (°)
- T: auger torque needed to drive the plug (N·m)
- A: cross-sectional area of the transport flute (m²)
- r_m: mean radius of the flight (m)
- \alpha: helix angle of the transport flight (°)
- \phi_f: friction angle between cuttings and the flight (°)

## 7 Thermal limits

Moon. The cuttings must keep their ice. In vacuum, ice on a warm grain sublimates freely at the Hertz–Knudsen rate, with the ice vapour pressure of [27]:

J = p_v(T)\sqrt{\frac{M}{2\pi R T}}

where

- J: mass of ice leaving the surface per unit area and time (kg/(m²·s))
- p_v(T): saturation vapour pressure of ice at temperature T (Pa)
- M: molar mass of water, 0.018 kg/mol
- R: universal gas constant, 8.314 J/(mol·K)
- T: temperature of the ice surface, taken as the bit temperature (K)

The limit allows a 1 % ice loss from cuttings grains of 25 µm radius over one 300 s bite cycle. This gives the critical bit temperature Tcrit = 163.5 K.

Mars. At about 600 Pa, the risk is transient melting and refreezing that welds the bit in place. The limit is set 10 K below melting: Tcrit = 263.1 K. Perchlorate brines can form at lower temperatures, which is a known open risk.

Bit thermal model. The bit has a heat capacity C = 23.4 J/K, the energy needed to raise its temperature by 1 K. It absorbs 25 % of the bit-face power [28]. It loses heat by conduction into the hole wall (cylinder shape factor) and into the fresh cuttings. Peak simulated temperatures were 120 K on the Moon and 205 K on Mars, both below Tcrit, so no thermal fault was raised.

Warm-up. 95 W of heaters bring 2.1 kg of actuators up to the lubricant limit plus margin (213 K). That takes 18.9 min on the Moon (from 100 K) and 3.6 min on Mars (from 192 K).

## 8 Solar array: configuration trade

The four 0.68 m² panels were evaluated in five arrangements over a full lunar day and a Mars sol at L_s = 90^\circ with \tau = 0.45. L_s, the areocentric solar longitude, is the angle Mars has travelled around the Sun since its northern spring equinox. It is the standard measure of the Martian season: L_s = 0^\circ is northern spring and L_s = 90^\circ is the northern summer solstice [29], the season in which Phoenix operated [12]. \tau is the dust optical depth (dimensionless), which reduces the direct beam reaching the panels as

G_b = S\, e^{-\tau / \sin \theta_{el}}

where

- G_b: direct solar irradiance at the surface (W/m²)
- S: solar irradiance above the atmosphere at Mars’s distance from the Sun (W/m²)
- \theta_{el}: elevation of the Sun above the horizon (°)

The model includes the true sun path, cell temperature and packing factor, and ray-traced self-shading by the other wing, the deployed mast, its latch posts and the lander deck.

Selected: 2-axis tracking (azimuth + elevation). At the lunar south pole the sun circles the horizon at about 1.5° elevation [30], so panels have to stand vertical and follow it in azimuth. On Mars, at 68°N in summer, the sun climbs to about 47°, and a second (elevation) axis adds roughly 30 %. A first-order estimate, P = A\,\eta\,S (total panel area A = 2.72 m², cell efficiency \eta = 0.28), gives 1036 W on the Moon and 378 W on Mars. That estimate assumes the full irradiance falls squarely on the panels at all times. The modelled output is lower, mostly on Mars: northern summer is near aphelion (S ≈ 496 W/m²) and dust attenuates the beam.

## 9 Energy storage trade

Chemistry | Specific energy (Wh/kg) | Mass for 1375 Wh (kg) | Round-trip efficiency (dimensionless) | Minimum operating temperature (K)
Nickel-Hydrogen (Individual Pressure Vessel) | 55 | 25.0 | 0.82 | 233
Regenerative H2/O2 PEM Fuel Cell System | 250 | 5.5 | 0.58 | 253
Space-Grade Low-Temp Li-Ion (NCA) | 145 | 9.5 | 0.92 | 223

Specific energy is the stored energy per unit mass, so the pack mass is the 1375 Wh capacity divided by it. Round-trip efficiency is the energy recovered on discharge divided by the energy put in on charge.

Depth of discharge (DoD) is the fraction of the rated capacity that has been drawn out of the battery [31]:

DoD = 1 - \frac{E_{\min}}{E_{nom}}

where

- E_{nom}: nominal stored energy of the full battery, 1375 Wh
- E_{\min}: lowest stored energy reached during the mission (Wh)

The simulation starts with a full battery and updates it every second. When the array output P_{solar} exceeds the electrical load P_{load}, the surplus would charge the battery, but it is already full. When the load exceeds the array output, the battery supplies the difference. Over the simulated mission the tracked array delivers 857 W on the Moon and 249 W on Mars. The peak load is 130 W. The array therefore exceeds the load at every time step, with a smallest margin of 727 W (Moon) and 111 W (Mars). The battery is never drawn on, E_{\min} = E_{nom}, and the maximum depth of discharge is 0.0 % (Moon) and 0.0 % (Mars).

This result is correct, but it covers only the daytime drilling run of under one hour. The 1375 Wh capacity is a design choice for periods with no sun on the array: terrain shadow at the lunar pole, and the Martian nights that return later in the season. This simulation does not model those periods. In such periods the battery would be held above a 20 % state of charge (DoD ≤ 80 %), since deeper cycling shortens battery cycle life [31]. Among the chemistries, the regenerative fuel cell is lightest (5.5 kg), but its 0.58 round-trip efficiency means more solar energy is needed to refill it. Li-ion, at 9.5 kg and 0.92 efficiency, is the lower-risk choice inside the warm box.

## 10 Sensitivity to uncertain coefficients

Coefficient | Value (dimensionless) | Moon mission time (h) | Moon peak bit temperature, Tmax (K) | Mars mission time (h) | Mars peak bit temperature, Tmax (K) | Faults (count)
Percussive specific energy ratio, cp = SEp / σc | 1.0 | 0.94 | 108 | 0.68 | 198 | 0
Percussive specific energy ratio, cp = SEp / σc | 3.0 | 0.96 | 120 | 0.76 | 205 | 0
Percussive specific energy ratio, cp = SEp / σc | 5.0 | 0.98 | 129 | 0.84 | 211 | 0
Fraction of bit-face heat entering the bit | 0.15 | 0.96 | 112 | 0.76 | 200 | 0
Fraction of bit-face heat entering the bit | 0.25 | 0.96 | 120 | 0.76 | 205 | 0
Fraction of bit-face heat entering the bit | 0.35 | 0.96 | 128 | 0.76 | 210 | 0
Cuttings bulking factor, B | 1.3 | 0.94 | 120 | 0.73 | 205 | 0
Cuttings bulking factor, B | 1.5 | 0.96 | 120 | 0.76 | 205 | 0
Cuttings bulking factor, B | 1.6 | 0.98 | 120 | 0.77 | 205 | 0

Three coefficients in the model are known only within a range from experiments. This table re-runs the full mission simulation with each one set to the low, central and high ends of its range, one at a time, with every other input at its baseline. The middle row of each group is the baseline design. The question is how far the mission results move when a coefficient moves.

- Percussive specific energy ratio. This coefficient sets how much blow energy is needed to break a unit volume of ground, so it controls the drilling rate in the hard, icy layers. Raising it from 1 to 5 lengthens the Mars mission from 0.68 h to 0.84 h (23 %). On the Moon it goes from 0.94 h to 0.98 h. Mars is more sensitive because its icy layers are thicker, so more of the hole is drilled by percussion.
- Fraction of bit-face heat entering the bit. This changes only the bit temperature, not the mission time. At the high end the peak bit temperature is 128 K on the Moon and 210 K on Mars. Both remain well below the critical temperatures of 163.5 K and 263.1 K.
- Cuttings bulking factor. Loosened cuttings take up more volume than intact ground. A higher factor fills the flutes sooner and adds brushing time, but changes mission time by only a few minutes.

No case produced a fault. The mission time is dominated by auger trips and warm-up rather than by cutting, so the design is not sensitive to the exact values of these coefficients within their published ranges.

## 11 Derivation table

Every derived quantity used on this site, with the equation that produces it. The table scrolls.

Quantity (unit) | Value | Equation | Note
hammer_mass_kg (kg) | 0.379 | m_h = rho pi (r_o^2 - r_i^2) h | hammer ring 56 mm OD on the 18 mm spline x 22 mm
wob_lift_off_moon_n (N) | 72.9 | WOB_lim = m g | lander lift-off limit, moon
wob_setpoint_moon_n (N) | 52.07 | WOB_set = m g / FOS | FOS = 1.4
wob_lift_off_mars_n (N) | 166.95 | WOB_lim = m g | lander lift-off limit, mars
wob_setpoint_mars_n (N) | 119.25 | WOB_set = m g / FOS | FOS = 1.4
impact_energy_j (J) | 2.25 | E = 1/2 k h^2 | spring energy released per blow
blow_frequency_hz (Hz) | 26.0 | f = n_lobes x cam_rps
hammer_impact_velocity_m_s (m/s) | 3.446 | v = sqrt(2E/m_h) | m_h = 0.379 kg from CAD hammer geometry
impact_peak_force_n (N) | 5416.7 | F = v Z_h Z_r / (Z_h + Z_r), Z = rho c A | 1-D stress-wave impact (Lundberg 1982)
hammer_spring_natural_hz (Hz) | 91.4 | f_n = sqrt(k/m_h) / 2pi | must exceed 2 x blow rate so the hammer re-seats each cycle
percussive_min_wob_n (N) | 44.1 | W_min = m_h v (1+e) f | mean impulse flux the bit must react to stay seated
hammer_spring_wire_mm (mm) | 6.0 | min d : all spring checks pass | 17-7PH; coil D = (G d^4 / 8 k n_a)^(1/3) = 31.5 mm, index 5.25
hammer_spring_active_coils | 3.14 | n_a = G d^4 / (8 D^3 k) | >= 3 for a linear rate; squared & ground ends
hammer_spring_free_length_mm (mm) | 37.8 | L0 = (n_a + 2) d + (1 + xi) h | solid 30.9 mm, clash allowance xi = 0.15
hammer_spring_shear_mpa (MPa) | 360.3 | tau = K_w 8 F D / (pi d^3) | F = k h = 750 N; allowable 690 MPa
hammer_spring_fatigue_fos | 1.55 | n = S_sa / tau_a (Zimmerli-Goodman, r = 1) | unpeened Zimmerli data, S_su = 0.67 S_ut; required 1.5
hammer_spring_slenderness | 1.2 | L0 / D < 2.63 / alpha | alpha = 0.5 (ends on parallel plates): absolutely stable, no buckling
hammer_spring_surge_hz (Hz) | 682.0 | f = 1/2 sqrt(k / m_coils) | >= 15 x 26 Hz blow rate
percussive_mech_power_w (W) | 58.5 | P = E f
percussive_elec_power_w (W) | 76.47 | P_el = E f / (eta_m eta_cam)
bit_edge_line_load_n_mm (N/mm) | 270.8 | w = F_imp / (n_c L_edge)
bit_edge_radius_mm (mm) | 1.0 | R >= w E* / (pi (sigma_c/FOS)^2) | Hertz line contact on a basalt clast; minimum 0.92 mm rounded up to 0.25 mm
bit_edge_contact_fos | 2.08 | sigma_c,WC / p_max | p_max = 2399 MPa on the clast
bit_crushing_ratio | 35.7 | p_max(rock) / UCS_max | must exceed 3.0; hardest layer UCS 22 MPa
bit_wedge_angle_deg (deg) | 85.0 | beta = 90 - alpha - gamma | rake -10.0 deg, clearance 15.0 deg
bit_index_angle_deg (deg) | 34.6 | theta = 360 N / (60 f) | rotation between hammer blows
bit_index_spacing_gauge_mm (mm) | 6.34 | s = a theta | each blow strikes fresh rock this far from the previous crater at the gauge
auger_endurance_limit_mpa (MPa) | 326.6 | S_e = 0.5 S_u k_a k_e | Marin-corrected
sampling_flute_depth_mm (mm) | 7.0 | h_f = (D_o - d_root)/2 | deepest flute whose root passes fatigue FOS 1.5 and yield FOS 1.25
sampling_root_od_mm (mm) | 6.0 | min d_r : n_Goodman >= FOS | impact 191.6 MPa + torsion 191.0 MPa -> n_f = 1.63
sampling_pitch_mm (mm) | 13.0 | p <= mu_f pi d_mean | helix angle at mean radius below friction angle atan(0.32) = 17.7 deg
sampling_length_mm (mm) | 225 | L_s = z_bite A_hole B m / A_flute | A_flute = 283 mm^2 per mm, bulking 1.5, margin 1.2
choking_onset_bite_m (m) | 0.1225 | z_crit = L_s A_flute / (A_hole B) | continuous penetration at which sampling flutes are full
transport_helix_angle_deg (deg) | 36.13 | alpha* = 45 - phi_f/2 | maximises screw efficiency tan(a)/tan(a+phi) (Shigley power-screw result)
transport_pitch_mm (mm) | 39.0 | p = pi d_mean tan(alpha*)
conveying_lift_ratio_moon | 0.64 | mu_w omega^2 r / g | < 1: cuttings are not lifted continuously -> they stay in the sampling flutes (bite drilling). Continuous conveying would need > 188 rpm
conveying_lift_ratio_mars | 0.279 | mu_w omega^2 r / g | < 1: cuttings are not lifted continuously -> they stay in the sampling flutes (bite drilling). Continuous conveying would need > 284 rpm
wearflat_total_length_mm (mm) | 0.66 | l = n_c r_edge (l/r)
bit_junk_slot_width_mm (mm) | 8.0 | 2 w d >= A_channel | 2 slots x 5.0 mm deep; flute channel 80 mm^2
bit_braze_fos | 15.0 | tau_braze / (F_t / A_braze) | tangential force 619 N per insert at the torque limit
bit_joint_shoulder_stress_mpa (MPa) | 61.6 | F_imp / A_shoulder | FOS 16.2 on yield; impact passes through the shoulder, not the thread
bit_joint_thread_shear_mpa (MPa) | 5.35 | ~ 4 T / (pi d_p^2 L_e) | right-hand thread: drilling torque tightens the joint
planetary_teeth (sun/planet/ring) | 12/36/84 | i = 1 + Z_r/Z_s, Z_p = (Z_r - Z_s)/2 | 3 planets: assembly (Z_s+Z_r)/n integer True, neighbour clearance True
rotary_motor_torque_nm (N m) | 0.462 | T_m = T_max / (i eta_g) | 6.5 N m at the spindle through 16:1, eta = 0.88
rotary_motor_rotor_d_mm (mm) | 30.9 | D_r = (4 T / (pi TRV lambda))^(1/3) | TRV = 20 kN m/m^3, L/D = 1.0; stack 30.9 mm
rotary_motor_stator_od_mm (mm) | 54.1 | D_s = D_r / split ratio | frameless BLDC kit class; 3840 rpm max, 186 W shaft power at the torque limit
planetary_module_mm (mm) | 0.5 | min m : sigma_b <= S_t/S_F and sigma_H <= S_c/S_H | sun mesh F_t = K_g T_s / (n r_s); bending FOS 3.36, contact FOS 1.48
spur_module_mm (mm) | 1.25 | Lewis: sigma = K_v F_t / (b m Y); AGMA: sigma_H = Z_E sqrt(K_v F_t / (b d I)) | 12T/24T, centre distance 22.5 mm; bending FOS 3.1, contact FOS 1.34
spur_bending_mpa (MPa) | 122.6 | sigma_b = K_v F_t / (b m Y) | S_t = 380 MPa (9310 carburised)
spur_contact_mpa (MPa) | 923.4 | sigma_H = Z_E sqrt(K_v F_t / (b d_p I)) | S_c = 1240 MPa
hammer_fall_time_ms (ms) | 2.74 | t_f = (pi/2) sqrt(m_h / k) | hammer released from full lift
cam_dwell_deg (deg) | 30.0 | delta >= margin x 360 n_cam t_f | margin 2.0, rounded up to 5 deg
cam_rise_deg (deg) | 150.0 | beta = 360/n_lobes - delta | cycloidal rise, then a cliff that drops the hammer
cam_mean_radius_mm (mm) | 35.0 | R_m = r_hammer + spigot gap + w_roller/2 | roller track radius
cam_pressure_angle_deg (deg) | 8.7 | phi = atan((ds/dtheta)_max / R_m), (ds/dtheta)_max = 2 h_c / beta | <= 30.0 deg (cycloidal: zero acceleration at both ends of the rise)
cam_torque_peak_nm (N m) | 2.641 | T = k s(theta) s'(theta) / eta_cam | RMS 1.253, mean 0.796 N m
cam_torque_mean_check_nm (N m) | 0.796 | T_mean = n_lobes E / (2 pi eta_cam) | energy balance agrees with the integrated profile
cam_roller_contact_mpa (MPa) | 528.0 | p = sqrt(F E* / (pi R L)) | F = k h / 2 = 375 N per roller (two rollers); allowable 992 MPa
cam_gear_module_mm (mm) | 1.75 | m >= (D_brg + 2 rim) / (Z - 2.5) and AGMA checks | 18T/54T ring gear on the cam; packaging-driven, bending FOS 35.93
percussive_motor_torque_nm (N m) | 0.426 | T_m = T_cam,rms / (i eta) | peak 0.898 N m; 2790 rpm at nominal spindle speed
percussive_motor_stator_od_mm (mm) | 52.7 | D_s = (4 T / (pi TRV lambda))^(1/3) / split | sized on RMS (thermal) torque
spline_flank_pressure_mpa (MPa) | 4.56 | p = 2 T / (d z h_w L K), h_w = 0.9 m | Involute spline DIN 5480 W18x1.25x13, 16 mm anvil engagement; allowable 40 MPa (sliding hub)
spindle_torsion_fos | 60.4 | tau = 16 T d / (pi (d^4 - d_i^4)); n = S_y / (sqrt3 tau) | at the spline root d = 15.25 mm, bore 6 mm, tau = 9.6 MPa
leadscrew_offset_mm (mm) | 65.0 | y_ls >= R_housing + r_screw + 2 mm | Tr16 screw passes the cam-gear housing; bronze nut clamped in the top yoke
drill_head_height_mm (mm) | 321.2 | sum of the derived axial stack | carriage underside to the top of the load-cell yoke
spindle_bearing_l10_h (h) | 104061.0 | L10h = (C/P)^3 10^6 / (60 n); P = 0.67 F_r + 1.41 F_a | SKF 7004 ACD/P4A pair, back-to-back: C = 1.62 C_single; F_a = WOB_lim + k h = 917 N, F_r = 126 N; required 400 h
spindle_bearing_s0 | 10.1 | s0 = C0 / (F_r + 0.76 F_a) | >= 2.0
upper_bearing_l10_h (h) | 35847.0 | L10h = (C/F_r)^3 10^6 / (60 n) | SKF 61804 (thin section), floating; F_r = 588 N from the overhung 24T gear (F = 461 N)
cam_bearing_l10_h (h) | 18528.0 | P = 0.56 F_r + Y F_a (Y from f0 F_a / C0) | SKF 61812 (thin section): F_a = k h = 750 N, F_r = 59 N, Y = 1.52, 930 rpm; s0 = 27.8
load_cell_capacity_n (N) | 500.0 | min standard range >= factor x WOB_lim,max | 334 N needed; error 1.25 N vs 5.0 N contact threshold
leadscrew_nut_pressure_mpa (MPa) | 0.34 | p = F / (pi d_2 h_1 n_t) | Tr16x4 bronze nut 24 mm long, F = 179 N; allowable 11 MPa
leadscrew_self_locking | True | mu / cos(alpha/2) > tan(lambda) | lead angle 5.20 deg: WOB cannot back-drive the screw when the feed motor is unpowered
flight_stall_plug_pressure_kpa (kPa) | 3483.6 | sigma = T_max / (A_tr r_m tan(alpha + phi_f)) | largest plug pressure the motor can push against before it stalls (screw-torque model)
flight_root_bending_mpa (MPa) | 65.3 | sigma = 3 q L^2 / t^2 | flight strip L = 3.0 mm, t = 1.2 mm; yield FOS 15.3
flight_impact_inertia_mpa (MPa) | 135.6 | q = DLF rho t a, a = (sigma/rho c) / (2 L_h / c) | wave-front acceleration 39,394 g, DLF 2.0: cycles at the blow rate
flight_required_cycles | 37400000.0 | N = f_blow x t_drill x life factor
flight_weld_shear_mpa (MPa) | 56.8 | tau = sqrt((M'/(a d_c))^2 + (V'/2a)^2), a = 0.707 w | static: 0.8 mm fillets, allowable 0.30 F_EXX = 321 MPa (ratio 5.6)
flight_weld_fatigue_life_cycles | 200000.0 | N = 2e6 (FAT / dsigma)^3 above the CAFL | stress range 136 MPa vs constant-amplitude limit 37 MPa (IIW FAT 63): fails the 3.7e+07-cycle requirement -> welded flights rejected
flight_root_fatigue_fos | 2.21 | 1 / (K_f sigma_a / S_e + K_f sigma_m / S_u) | integral flight, root fillet r = 0.5 t, K_f = 1.36; plug load as mean, blows as alternating
shank_braze_lap_mm (mm) | 3.0 | L_b = max(3 t, 2 T FOS / (pi d^2 tau_b)) | torque alone needs 0.18 mm; the 3 t lap rule (AWS) governs
shank_braze_fos | 18.8 | tau_b / sqrt(tau_T^2 + tau_pull^2) | torque 7.0 MPa + pull-out at the 500 N load-cell rating 3.8 MPa; impact bears on the socket floor
hex_shank_torsion_mpa (MPa) | 12.9 | tau = 16 T s / (pi (s^4 - d_b^4)) | inscribed circle of the 13.86 mm A/F hex (conservative vs Roark's hexagon); bore 6 mm
hex_socket_flank_pressure_mpa (MPa) | 3.47 | p = 2 T / (d_m h L n k) | 6 flats, 52 mm in the anvil socket; allowable 40 MPa (as the spline)
hex_shank_impact_stress_mpa (MPa) | 47.3 | F_imp / A_net (pin section) | net hex area 114 mm^2; yield FOS 21.1
retention_pin_shear_mpa (MPa) | 35.4 | tau = F / (2 pi d^2/4) | double shear at the 500 N load-cell rating (the largest pull the feed can apply and still measure)
hex_shank_engagement_mm (mm) | 52.0 | hex_top - anvil_bottom (drill-head stack)
auger_string_mass_kg (kg) | 0.545 | sum rho (A_tube + A_flight t/p) ds | bit to anvil; flights add mass, not bending stiffness
string_buckling_load_n (N) | 3294.0 | K phi = P K_g phi (bushing + hole wall as supports) | lowest over the stroke at 0.0 m; FOS 19.7 on the 167 N lift-off WOB
string_buckling_no_bushing_n (N) | 581.0 | clamped at the anvil, pinned at the bit only | FOS 3.5: still stable, the bushing is not needed for buckling
string_lateral_f1_hz (Hz) | 46.0 | K phi = omega^2 M phi, under the lift-off WOB | lowest over the stroke (start of the hole, longest free span); 1.77 x the 26 Hz blow rate
string_lateral_no_bushing_hz (Hz) | 19.4 | same model without the mast-foot guide bushing | 0.75 x blow rate: inside the +/-20 % band, so the bushing is required
string_whirl_margin | 11.5 | f1 / (N_max / 60) | first lateral mode vs the fastest shaft speed (no whirl critical speed in the RPM range)
string_torsional_f1_hz (Hz) | 393.0 | K_t phi = omega^2 J phi (clamped at the anvil, bit free) | 15.1 x the blow rate
string_windup_deg (deg) | 13.24 | theta = T int ds / GJ | at the 6.5 N m limit; the 6/4 mm sampling root is 80 % of the compliance
string_windup_energy_j (J) | 0.751 | U = T theta / 2 | released into the bit if it breaks free after a stall (stick-slip)
transport_tube_torsion_mpa (MPa) | 26.2 | tau = T r_o / J
thermocouple_path_fill | 0.062 | (d_lead / d_bore)^2 | narrowest bore: sampling root 4 mm; lead 1.0 mm runs bit -> tube -> spindle -> slip ring
brush_tuft_count | 14 | min N: tufts clear the flights (worm-wheel entry) and fit the hub | tuft 9.4 mm thick in an 11.4 mm flute (backlash 1.0 mm each side), 1 mm hub ligament
brush_pitch_radius_mm (mm) | 28.97 | R_p = N p / (2 pi) | wheel circular pitch = flight pitch 13.0 mm
brush_axle_offset_mm (mm) | 35.47 | a = R_p + r_m | auger axis to brush axle (pitch circle on the mean flute radius)
brush_tip_radius_mm (mm) | 32.67 | R_t = a - r_root + delta | tips pass 0.2 mm beyond the flute root
brush_tuft_lean_deg (deg) | 17.66 | lambda = atan(p / (2 pi r_m)) | tufts lean at the flight lead angle (worm-wheel helix)
brush_speed_ratio | 14 | omega_a / omega_b = N (single-start worm) | 4.64 rpm at the 65 rpm transfer speed; transport pitch / sampling pitch = 3.00
cuttings_passive_pressure_kpa (kPa) | 4.44 | sigma_p = 2 c sqrt(K_p) + gamma h K_p | Rankine passive, K_p = 4.60; c = 1.0 kPa, Mars gravity, densest layer bulked
brush_contact_force_budget_n (N) | 0.441 | F <= k_string x lead-in chamfer | string stiffness at the brush 294 N/m (bit tip) with the bit above the guide bushing
bristle_wire_mm (mm) | 0.1 | thickest stock wire: Goodman, force budget, strip pressure | 17-7PH, free length 9.2 mm, 13787 bristles per tuft (60% fill)
bristle_stress_mpa (MPa) | 72.0 | sigma = 3 E d delta / (2 L^2) | Goodman FOS 12.75 (0 -> sigma once per brush turn)
bristle_tip_pressure_kpa (kPa) | 58.8 | p = (3/16) phi E d^2 delta / L^3 | 13 x the cuttings' passive pressure: the root is scraped clean
brush_contact_force_n (N) | 0.362 | N = sum 3 E I delta_i / L^3 over the root contact | 82 % of the force budget
brush_sweep_speed_mm_s (mm/s) | 2.61 | v = (2 sqrt(R_t^2 - (a - r_root)^2) / N_pass) x n/60 | root-contact patch 7.2 mm along the auger
transfer_duration_s (s) | 87 | t = L_s / v_sweep
brush_spring_preload_n (N) | 0.362 | F_pre = N (arm floats on the bristles) | preload equals the required bristle force; the arm follows the string as it deflects
brush_spring_wire_mm (mm) | 0.8 | thinnest stock wire: K_i 32 M / (pi d^3) x FOS <= S_sy/0.577 | torsion spring on the 4 mm pivot pin: index 6.6, 3 coils, wound up 14 deg, 447 MPa
brush_force_rise_crown_pct (%) | 3.73 | dF/F = k_t (step / L_arm) / (L_arm F) | when the 0.5 mm gauge step of the bit crown lifts the brush
brush_bushing_pv_pa_m_s (Pa m/s) | 8.7 | PV = (F/2)/(d L) x omega_b d/2 | Vespel SP-3 flanged bushing: 0.0025 % of the 0.35 MPa m/s limit
brush_drag_torque_nm (N m) | 0.00294 | T = F_plough r_m + mu N r_root + T_bush / N | plough 2.26 + bristle friction 0.65 + brush bushings 0.019 mN m (full flutes)
brush_idle_drag_torque_nm (N m) | 0.00067 | T = mu N r_root + T_bush / N | empty flights passing the brush while drilling
bite_cuttings_volume_cm3 (cm^3) | 52.0 | V = z_bite A_hole B
chute_angle_deg (deg) | 32 | theta >= atan(mu_w) + margin | wall friction angle 21.8 deg on bronze (g-independent for dry flow)
sample_cup_id_mm (mm) | 37.8 | pi/4 D^2 h >= V_bite x margin | 62.4 cm^3 (120% of one bite); 55.5 mm deep, the most the 30 mm ground clearance under the foot plate allows
chute_flow_depth_mm (mm) | 0.193 | h = Q / (w sqrt(2 g' L/2)), g' = g (sin th - mu cos th) | brush delivers 0.60 cm^3/s; lunar sliding flow, 8 mm side walls; run 36 mm
carousel_stations | 11 | N = ceil(depth / bite) cups + blank station | 10 sealed cups, one per bite; the blank station sits under the port at launch and after the last bite
carousel_pitch_radius_mm (mm) | 82.0 | R = N_st (D_f + gap) / (2 pi) | seal flange 42.8 mm, 4 mm between neighbours; axis 125 mm fore of the auger, port-cup flange 2.0 mm from the guide-bushing flange
carousel_mass_kg (kg) | 0.824 | sum rho V (1 + MGA) | turntable 272 g, 10 cups x 23 g, index motor 185 g; hung from the mast foot plate, which grows a disc of radius 105 mm to cover the cups
carousel_index_torque_nm (N m) | 0.3128 | T = 2 (T_seal + T_hub) + 1.25 J alpha | face seals 156 mN m + hub bearing 0.133 mN m + inertia 0.811 mN m (J = 81.3 kg cm^2, all cups full); motor rated 0.70 N m
carousel_index_power_w (W) | 0.075 | P = T omega_max / eta | 32.7 deg in 6 s while the auger descends, 0.45 J per index; empty and balanced at launch, so linear launch loads put no torque on the drive
brush_stow_angle_deg (deg) | 13.4 | psi = asin((R_t - (a - r_gauge) + c) / L_arm) | arm swung away so the tips clear the bit gauge by 5 mm: launch lock + dry-heat bake-out position
mast_spine_fore_face_mm (mm) | 108.0 | y = y_ls + r_flange + c + d_bracket | rail brackets clear the Tr16 nut flange by 5 mm; carriage bushing pairs 262 mm apart
rail_span_max_mm (mm) | 801.0 | f = (pi / 2 L^2) sqrt(EI / m) >= f_launch | Ø16 rail between supports; end-supported over 1785 mm it would be 10 Hz
mast_stow_carriage_drop_mm (mm) | 701.0 | argmax_delta min(f_screw, f_string) | launch pose: carriage 701 mm below home, bit 491 mm through the foot. The nut splits the leadscrew and the guide bushing props the string (at home: screw 10 Hz, string 6 Hz)
leadscrew_stowed_f1_hz (Hz) | 22.1 | K phi = w^2 M phi: fixed top bearing, nut, support bearing | local mode (not the stowed primary); launch load 15.0 g (Miles 3-sigma vs 15 g quasi-static)
leadscrew_launch_stress_mpa (MPa) | 124.2 | sigma = M c / I (minor diameter d3) | yield FOS 2.5 (AISI 1045); peak sag 8.44 mm vs 15 mm to the rail brackets
string_stowed_f1_hz (Hz) | 22.8 | auger-string FE model with the bushing as launch support | local mode; launch load 15.0 g, peak bending 200 MPa (yield FOS 5.0), sag 9.71 mm
bit_side_force_n (N) | 619.0 | F = T_max / r_gauge | one insert hung up on a clast at the torque limit: the largest unbalanced lateral force at the bit
bit_side_reaction_carriage_n (N) | 77.9 | R_A = 3 a F / (2 L), R_B = F + R_A | string clamped at the carriage, propped by the bushing 96 mm above the bit: the foot takes 697 N
mast_section (mm) | 80x80x3 6061-T6 Al | min (m_spine + m_posts + m_brackets) over feasible candidates | 64 of 240 (material, section, brackets, latch height) candidates pass the deployed checks
mast_latch_height_mm (mm) | 250.0 | latch posts: chosen with the section | latch at z = 715 mm; 1182 mm of spine above it
rail_bracket_count | 4 | spans <= L_max and the alignment budget | 4 brackets, 357 mm spans (2 needed for the launch mode alone); rail flex tilts the carriage 441 urad
mast_spine_mass_kg (kg) | 5.41 | m = rho A L (1 + MGA) | A = 924 mm^2 over 1807 mm; MGA 20% (AIAA S-120A)
mast_deployed_f1_hz (Hz) | 20.0 | K phi = w^2 M phi: hinge + latch, carriage over the drilling stroke | 20.0-21.2 Hz from the start of the hole to 1 m; outside the rotary 1-4 Hz, cam 13 Hz and blow 26 Hz bands (+/-20%); 2% from the nearest band edge
mast_home_f1_hz (Hz) | 18.1 | same model, carriage at home (no percussion there)
mast_stowed_f1_hz (Hz) | 96.9 | hinge + hold-down(s), carriage at the stow pose | requirement 50 Hz; 2 hold-down(s) (one at the crosshead alone gives 44.9 Hz)
mast_alignment_offset_mm (mm) | 0.486 | e = w_c + phi_c L_cb - w_b at WOB_lim (+ side force) | the string leaves the carriage 0.486 mm off the bushing axis vs the 0.5 mm bushing clearance
bit_alignment_error_1m_mm (mm) | 3.702 | e = theta (z_bush + 1 m), theta = offset / L_cb | string tilt 697 arc-s about the bushing at full depth (hole-wall guidance ignored)
mast_buckling_load_n (N) | 111272.0 | P_cr = pi^2 EI_min / (2 L)^2 above the latch | the spine is in tension while drilling; compression only when pulling a stuck string (510 N): FOS 218
mast_launch_stress_mpa (MPa) | 46.8 | sigma = M c / I, launch g = max(QS, Miles 3-sigma) | yield FOS 5.1 (>= 1.25), ultimate FOS 5.6 (>= 1.4)
mast_rotating_mass_kg (kg) | 24.92 | spine + rails + brackets + screw + carriage + crosshead + foot | incl. the 3.2 kg carriage and string; MGA 20%
hinge_lug_load_n (N) | 14525.0 | max(R_n/2, R_lat/2 + M/s, m g_ax / 2) at launch | two Ti lugs 88 mm apart; the hinge also takes the launch load along the stowed mast
hinge_pin_d_mm (mm) | 6.0 | min d: tau FOS_u <= S_u/sqrt3, bearing FOS_y <= S_y,lug | 17-4PH pin in double shear 257 MPa (FOS 2.4), lug bearing 303 MPa
hold_down_tension_n (N) | 6586.0 | hold-down reaction, launch g = max(QS, Miles 3-sigma) | 2 hold-down(s); the hinge is the other support
hold_down_bolt | M8 | min A_s: P_pre >= FS_sep FOS_u P_t and P_pre + FOS_u P_t <= S_u A_s | A-286 frangible bolt, preload 15582 N (65% of yield); SMA release (Frangibolt class), no pyro shock
deploy_gravity_torque_nm (N m) | 53.44 | T_g = m g_Mars max|dy cos th + dz sin th| | rotating mass 24.92 kg, CG 578 mm above / 141 mm fore of the hinge (home pose)
deploy_actuator_torque_nm (N m) | 107.73 | T = 2 (T_g + T_f + T_harness) + 1.25 J alpha | friction 0.069, harness 0.3, inertia 95.68 mN m (J = 19.74 kg m^2, 60 s); ECSS-E-ST-33-01C
deploy_motor_rotor_d_mm (mm) | 48.5 | D_r = (4 T_m / (pi TRV lambda))^(1/3), T_m = T / (i eta) | 100:1 strain-wave gear, eta 0.6: motor 1795 mN m. Earth tests need a g-offload (141 N m at 1 g)
latch_pin_load_n (N) | 647.0 | (R_latch,WOB + m g |dy| / h_l) / 2 posts | latch pin 6 mm, shear FOS 54: stiffness, not strength, sizes the latch
latch_engagement_energy_mj (mJ) | 8.35 | E = J w^2 / 2 at the end of the slew | absorbed by the spring latch pin and a Vespel stop; the actuator brakes over the last 10 % anyway
leadscrew_buckling_load_n (N) | 2005.0 | P_cr = pi^2 E I_3 / (0.7 L)^2 (fixed top bearing, nut pinned) | nut-to-top length 1330 mm at 1 m depth; FOS 12.0 on the 167 N lift-off WOB
leadscrew_critical_speed_rpm (rpm) | 558.0 | n_cr = (60/2pi)(3.927/L)^2 sqrt(EI/rho A) (fixed-supported) | 1785 mm between bearings; retraction 188 rpm = 34% of critical (limit 80%)
leadscrew_nut_launch_pressure_mpa (MPa) | 3.5 | p = m_c g_launch / (pi d_2 h_1 n_t) | launch along the stowed mast: the self-locking nut holds the carriage; allowable 11 MPa
lander_deck_length_m (m) | 1.5 | L >= z_top - z_hinge + hold-down pedestal | the stowed mast lies aft over the deck; 0.60 m wide, top 0.45 m above the regolith
lander_cg_offset_m (m) | 0.349 | y_G = sum m_i y_i / m (deployed) | drill 30.6 kg at y = 0.07 m, rest of lander 14.4 kg at the deck centre
lander_tilt_lift_off_ratio | 0.82 | WOB_tip / (m g) = a / (a + e) | a side-mounted drill unloads the near legs before the lander rises: tilt about the far legs 1.59 m behind the CG
lander_far_leg_line_m (m) | 1.938 | max(deck end + splay, y_G + e k / (FOS - k)), k = 1 + e_LC / WOB_set | WOB_set = m g / 1.4 is kept; near legs stay loaded at the set-point plus the load-cell error. Tilt margin 1.15 vs 1.4 for a drill through the CG
wob_tilt_limit_moon_n (N) | 59.77 | WOB_tip = m g a / (a + e) | set-point 52.07 N (margin 1.15); near legs 3.7 N, far 6.7 N each
lander_torque_reaction_fos_moon | 2.39 | mu sum N_i r_i / T_max (footpads about the drill axis) | footpad friction alone reacts the 6.5 N m torque limit at the WOB set-point
wob_tilt_limit_mars_n (N) | 136.88 | WOB_tip = m g a / (a + e) | set-point 119.25 N (margin 1.15); near legs 8.5 N, far 15.3 N each
lander_torque_reaction_fos_mars | 5.47 | mu sum N_i r_i / T_max (footpads about the drill axis) | footpad friction alone reacts the 6.5 N m torque limit at the WOB set-point
wing_axis_x_m (m) | 1.339 | x_w = W/2 + splay + sqrt((w/2)^2 + (h/2 sin beta)^2) + c | steepest tracking tilt 47 deg (Mars, Ls 90): the wing corner sweeps r = 0.74 m and clears the legs by 5 cm
wing_base_height_m (m) | 0.522 | z = deck top + azimuth platter + c | wings ride on azimuth turntables at the ends of deck outriggers, at the lander CG station
critical_bit_temp_moon_k (K) | 163.5 | J_HK(T) = p_v(T) sqrt(M/2piRT) = rho_ice dr/t_bite | <= 1 % ice loss from 25 um radius grains in 300 s (Murphy & Koop 2005)
critical_bit_temp_mars_k (K) | 263.15 | T_crit = 273.15 K - margin | prevents transient melting / refreezing of pore ice on the bit
actuator_warmup_target_k (K) | 213.0 | T_target = T_lube,min + margin
warmup_duration_moon_s (s) | 1132 | C dT/dt = Q_h - eps sigma A (T^4 - T_sky^4) - h A (T - T_amb) | C = 945 J/K, 100.0 K -> 213.0 K
warmup_duration_mars_s (s) | 217 | C dT/dt = Q_h - eps sigma A (T^4 - T_sky^4) - h A (T - T_amb) | C = 945 J/K, 192.0 K -> 213.0 K
bit_thermal_mass_j_k (J/K) | 23.39 | C = rho c_p V (crown + cutters + lowest flutes)
torque_fault_threshold_nm (N m) | 5.525 | tau_fault = f x tau_max

## References

[1]

J. Y. Wong, Theory of ground vehicles, 4 ed., John Wiley & Sons, 2008.

[2]

NASA, Structural design and test factors of safety for spaceflight hardware, NASA-STD-5001B, 2014.

[3]

R. G. Budynas and J. K. Nisbett, Shigley’s mechanical engineering design, 10 ed., McGraw-Hill, 2015.

[4]

J. C. Jaeger, N. G. W. Cook, and R. W. Zimmerman, Fundamentals of rock mechanics, 4 ed., Blackwell Publishing, 2007.

[5]

B. M. Das and K. Sobhan, Principles of geotechnical engineering, 8 ed., Cengage Learning, 2014.

[6]

W. D. Carrier, G. R. Olhoeft, and W. Mendell, Physical properties of the lunar surface, pp. 475–594, Cambridge University Press, 1991.

[7]

A. Shaw et al., “Phoenix soil physical properties investigation,” Journal of Geophysical Research: Planets, vol. 114, no. E1, 2009.

[8]

L. Gertsch, R. Gustafson, and R. Gertsch, “Effect of water ice content on excavatability of lunar regolith,” in AIP conference proceedings (STAIF 2006), vol. 813, pp. 1093–1100, 2006.

[9]

E. M. Schulson and P. Duval, Creep and fracture of ice, Cambridge University Press, 2009.

[10]

A. P. Zent et al., “Initial results from the thermal and electrical conductivity probe (TECP) on phoenix,” Journal of Geophysical Research: Planets, vol. 115, no. E3, 2010.

[11]

D. A. Paige et al., “Diviner lunar radiometer observations of cold traps in the moon’s south polar region,” Science, vol. 330, no. 6003, pp. 479–482, 2010.

[12]

P. H. Smith, L. K. Tamppari, R. E. Arvidson, et al., “\text{H}_2\text{O} at the phoenix landing site,” Science, vol. 325, no. 5936, pp. 58–61, American Association for the Advancement of Science, 2009.

[13]

M. T. Mellon et al., “Ground ice at the phoenix landing site: Stability state and origin,” Journal of Geophysical Research: Planets, vol. 114, no. E1, 2009.

[14]

W. C. Feldman, S. Maurice, A. B. Binder, B. L. Barraclough, R. C. Elphic, and D. J. Lawrence, “Fluxes of fast and epithermal neutrons from Lunar Prospector: Evidence for water ice at the lunar poles,” Science, vol. 281, no. 5382, pp. 1496–1500, 1998, doi: 10.1126/science.281.5382.1496 (https://doi.org/10.1126/science.281.5382.1496).

[15]

W. V. Boynton, W. C. Feldman, S. W. Squyres, T. H. Prettyman, J. Brückner, et al., “Distribution of hydrogen in the near surface of Mars: Evidence for subsurface ice deposits,” Science, vol. 297, no. 5578, pp. 81–85, 2002, doi: 10.1126/science.1073722 (https://doi.org/10.1126/science.1073722).

[16]

S. Li, P. G. Lucey, R. E. Milliken, et al., “Direct evidence of surface exposed water ice in the lunar polar regions,” Proceedings of the National Academy of Sciences, vol. 115, no. 36, pp. 8907–8912, 2018, doi: 10.1073/pnas.1802345115 (https://doi.org/10.1073/pnas.1802345115).

[17]

A. Colaprete, P. Schultz, J. Heldmann, et al., “Detection of water in the LCROSS ejecta plume,” Science, vol. 330, no. 6003, pp. 463–468, American Association for the Advancement of Science, 2010.

[18]

C. M. Dundas, A. M. Bramson, L. Ojha, J. J. Wray, M. T. Mellon, et al., “Exposed subsurface ice sheets in the Martian mid-latitudes,” Science, vol. 359, no. 6372, pp. 199–201, 2018, doi: 10.1126/science.aao1619 (https://doi.org/10.1126/science.aao1619).

[19]

T. Spohn, T. L. Hudson, L. Witte, T. Wippermann, L. Wisniewski, et al., “The InSight HP^3 mole on Mars: Lessons learned from attempts to penetrate to depth in the Martian soil,” Advances in Space Research, vol. 69, no. 8, pp. 3140–3163, 2022, doi: 10.1016/j.asr.2022.02.009 (https://doi.org/10.1016/j.asr.2022.02.009).

[20]

R. Teale, “The concept of specific energy in rock drilling,” International Journal of Rock Mechanics and Mining Sciences & Geomechanics Abstracts, vol. 2, no. 1, pp. 57–73, Elsevier, 1965.

[21]

K. Zacny, G. Paulsen, C. P. McKay, et al., “Reaching 1 m deep on mars: The icebreaker drill,” Astrobiology, vol. 13, no. 12, pp. 1166–1198, 2013.

[22]

E. Detournay and P. Defourny, “A phenomenological model for the drilling action of drag bits,” International Journal of Rock Mechanics and Mining Sciences & Geomechanics Abstracts, vol. 29, no. 1, pp. 13–23, 1992.

[23]

T. Richard, F. Dagrain, E. Poyol, and E. Detournay, “Rock strength determination from scratch tests,” Engineering Geology, vol. 147–148, pp. 91–100, 2012.

[24]

B. Lundberg, “Computer simulation of percussive drilling of rock,” International Journal of Rock Mechanics and Mining Sciences & Geomechanics Abstracts, vol. 19, no. 5, pp. 229–249, 1982.

[25]

H. Rabia, “Specific energy as a criterion for drill performance prediction,” International Journal of Rock Mechanics and Mining Sciences & Geomechanics Abstracts, vol. 19, no. 1, pp. 39–42, 1982.

[26]

H. A. Janssen, “Versuche über getreidedruck in silozellen,” Zeitschrift des Vereines Deutscher Ingenieure, vol. 39, no. 35, pp. 1045–1049, 1895.

[27]

D. M. Murphy and T. Koop, “Review of the vapour pressures of ice and supercooled water for atmospheric applications,” Quarterly Journal of the Royal Meteorological Society, vol. 131, pp. 1539–1565, 2005.

[28]

J. P. Loui and K. U. M. Rao, “Experimental investigations of pick-rock interface temperature in rock cutting,” in Proceedings of the indian geotechnical conference / int. J. Rock mech. Min. Sci. 34(3-4), 1997.

[29]

M. Allison and M. McEwen, “A post-Pathfinder evaluation of areocentric solar coordinates with improved timing recipes for Mars seasonal/diurnal climate studies,” Planetary and Space Science, vol. 48, no. 2–3, pp. 215–235, 2000, doi: 10.1016/S0032-0633(99)00092-6 (https://doi.org/10.1016/S0032-0633(99)00092-6).

[30]

Texas Tech University (ICES 2020), “Solar array configurations for the moon village,” https://ttu-ir.tdl.org/items/4b4c413c-d8ee-4540-8f97-c13c91f4532a, 2020, Sun elevation varies only about +/-1.5 deg near Shackleton; panels must face the horizon and track 360 deg.

[31]

D. Linden and T. B. Reddy, Handbook of batteries, 3 ed., McGraw-Hill, 2002.

Autonomous Low-Gravity Rotary-Percussive Bite-Drilling System (MBSE Digital Twin)

CAD models generated in code with the help of Claude (Anthropic)
