tilak-pentapati/Low-Gravity_Rotary-Percussive_Bite-Drilling_System/docs/assets/handout/design_summary.png

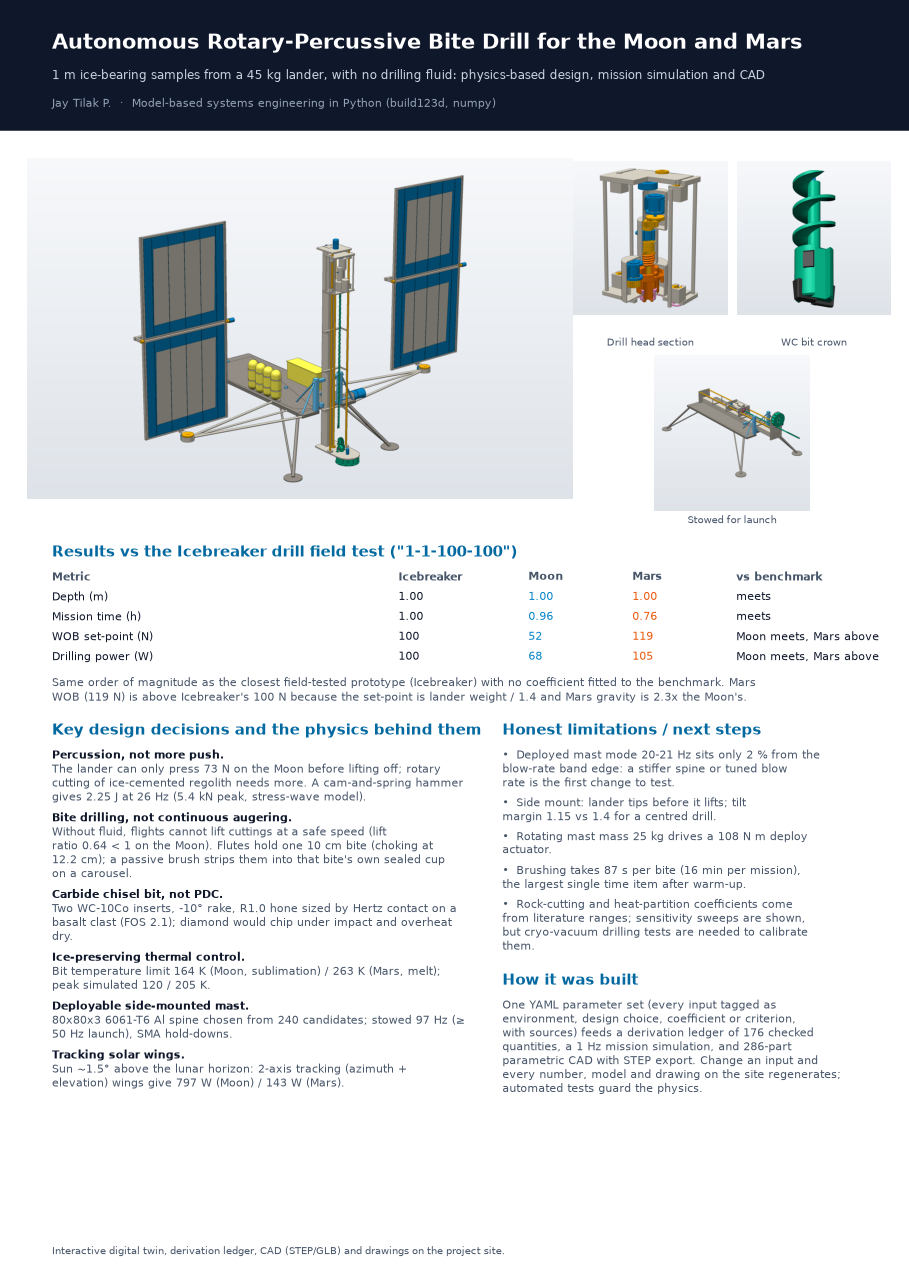
docs/assets/handout/design_summary.png
