tilak-pentapati/Low-Gravity_Rotary-Percussive_Bite-Drilling_System/docs/assets/renders/head_section.png

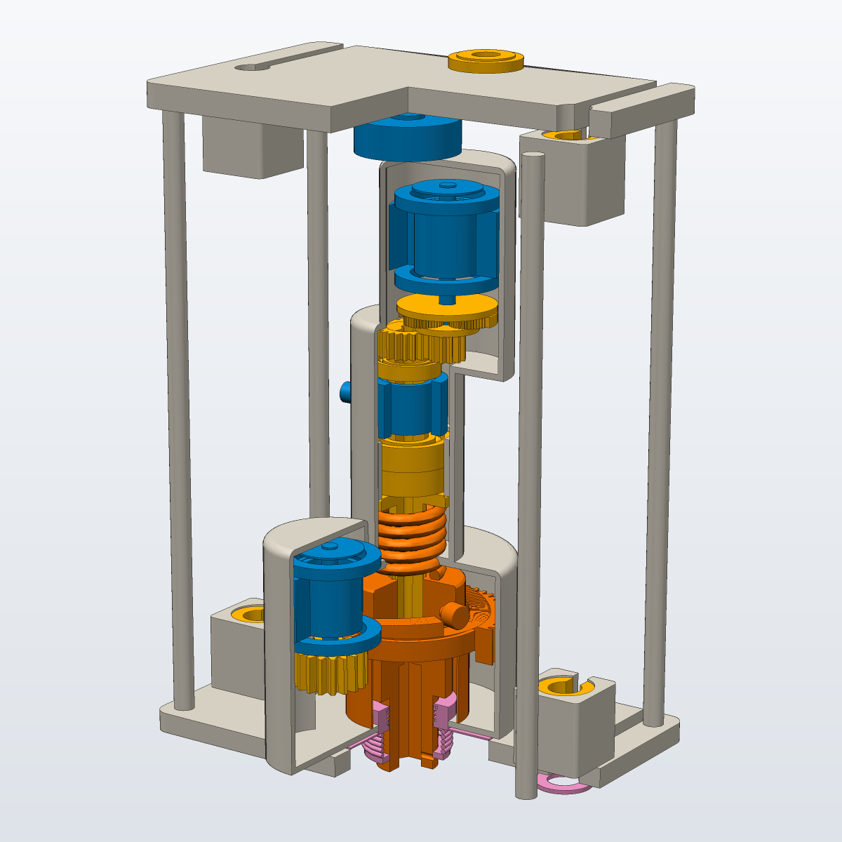
docs/assets/renders/head_section.png
