tilak-pentapati/Low-Gravity_Rotary-Percussive_Bite-Drilling_System/docs/assets/renders/mast_deployed.png

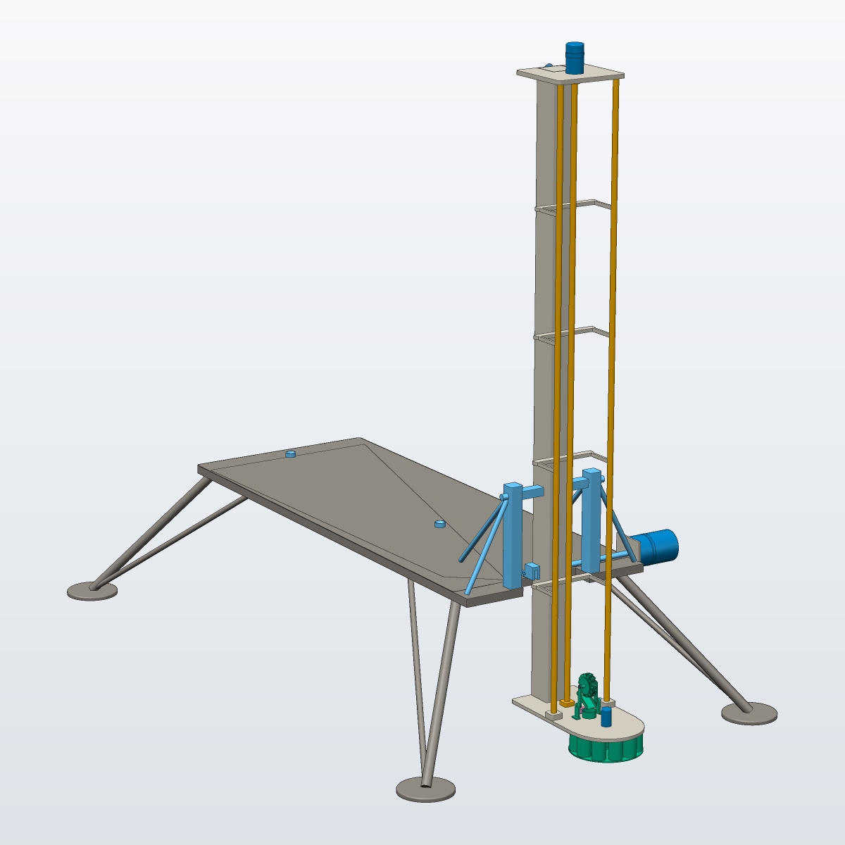
docs/assets/renders/mast_deployed.png
