tilak-pentapati/Low-Gravity_Rotary-Percussive_Bite-Drilling_System/docs/assets/renders/rig_deployed.png

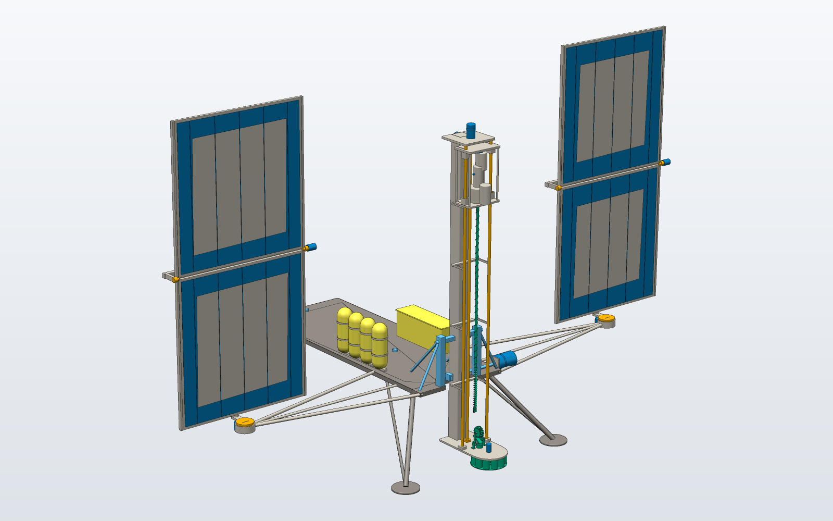
docs/assets/renders/rig_deployed.png
