tilak-pentapati/Low-Gravity_Rotary-Percussive_Bite-Drilling_System/docs/assets/cad/auger_bit.step

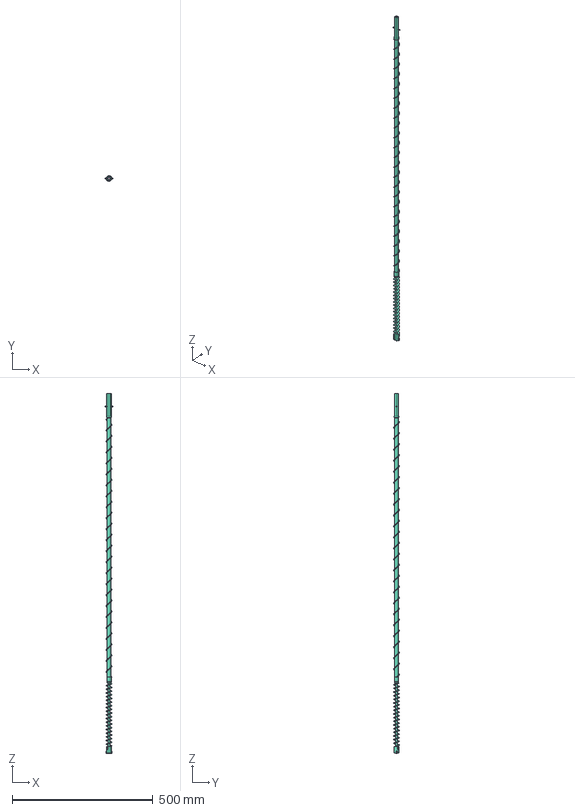
[picture p11: CAD file, 2026-10-22]
docs/assets/cad/auger_bit.step
29.6 x 20.0 x 1279.8 mm
WC_Insert_2 x 2
Bit_Crown_Body
Gauge_Reamer_Pad_1
Gauge_Reamer_Pad_2
Thermocouple_Probe
Sampling_Root_Shaft
Sampling_Flight
Bit_Sub_Shoulder
Bit_Sub_Pin_Thread
Joint_Coupling
Transport_Core_Tube
Transport_Helix_Flight
Hex_Drive_Shank
Retention_Spring_Pin
Shank_Braze_Fillet
TC_Coax_Contact
Thermocouple_Lead
Lead_Exit_Grommet
