tilak-pentapati/Low-Gravity_Rotary-Percussive_Bite-Drilling_System/docs/assets/cad/mast_stowed.step

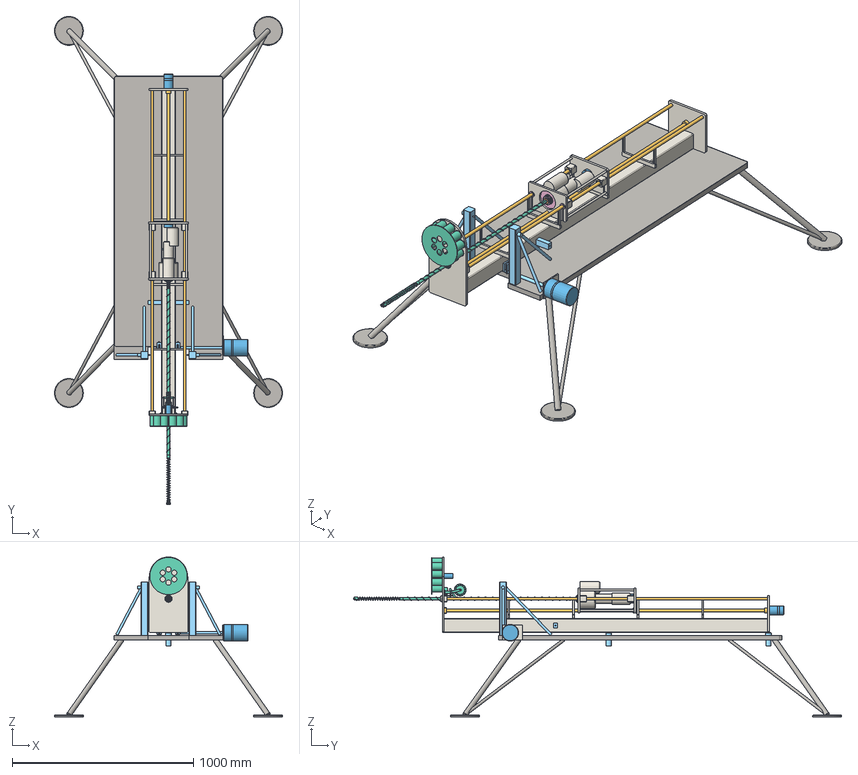
[picture p12: CAD file, 2026-10-22]
docs/assets/cad/mast_stowed.step
1260.0 x 2695.1 x 883.0 mm
Lander_Deck_Panel
Deck_Face_Sheet
Hinge_Tongue_L
Hinge_Pin_L
Hinge_Tongue_R
Hinge_Pin_R
Deploy_Torque_Shaft
Deploy_Actuator_BLDC_StrainWave
Deploy_Actuator_Band
Deploy_Actuator_Mount
Latch_Post_L
Latch_Post_Brace_Aft_L
Latch_Post_Brace_Out_L
Latch_Pin_L
Latch_Spring_Housing_L
Latch_Post_R
Latch_Post_Brace_Aft_R
Latch_Post_Brace_Out_R
Latch_Pin_R
Latch_Spring_Housing_R
Hold_Down_Pedestal_1
SMA_Frangibolt_1
Hold_Down_Pedestal_2
SMA_Frangibolt_2
Leg_1_Main
Leg_1_Brace
Leg_1_Footpad
Leg_2_Main
Leg_2_Brace
Leg_2_Footpad
Leg_3_Main
Leg_3_Brace
Leg_3_Footpad
Leg_4_Main
Leg_4_Brace
Leg_4_Footpad
Mast_Spine_80x80x3
Rail_Bracket_1
Rail_Bracket_2
Rail_Bracket_3
Rail_Bracket_4
Guide_Rail_L
Rail_Foot_Block_L
Guide_Rail_R
Rail_Foot_Block_R
Leadscrew_Tr16x4
Leadscrew_Support_Bearing
Leadscrew_Fixed_Bearing
Mast_Crosshead
Z_Feed_Motor
Z_Feed_Motor_Band
Mast_Foot_Plate
Hinge_Fork_L
Hinge_Fork_R
Latch_Lug_L
Latch_Lug_R
Hold_Down_Cone_1
Hold_Down_Cone_2
Guide_Bushing_Liner_SP3
Guide_Bushing_Boss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
