tilak-pentapati/Low-Gravity_Rotary-Percussive_Bite-Drilling_System/docs/assets/cad/drill_bit_exploded.step

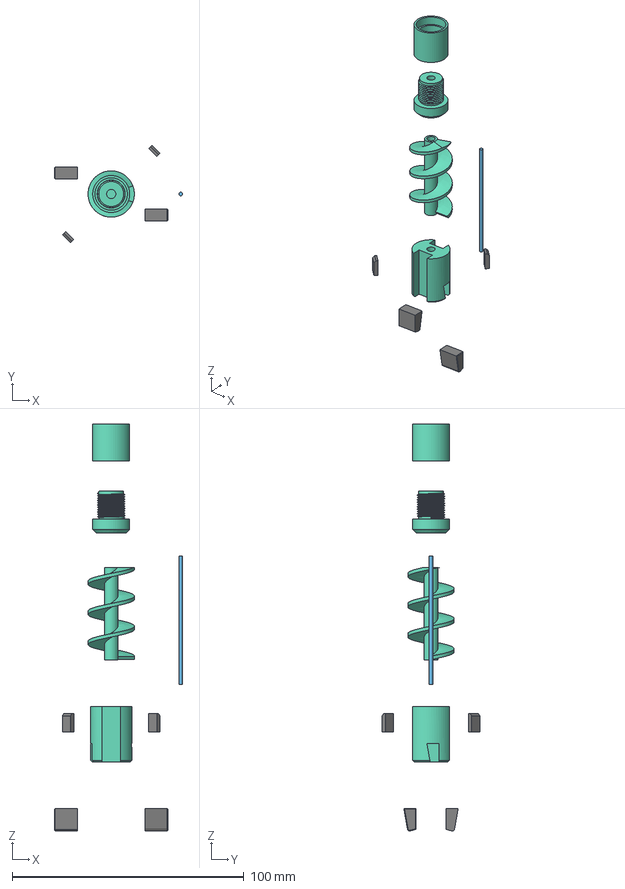
[picture p13: CAD file, 2026-10-22]
docs/assets/cad/drill_bit_exploded.step
55.3 x 42.2 x 175.8 mm
WC_Insert_2 x 2
Bit_Crown_Body
Gauge_Reamer_Pad_1
Gauge_Reamer_Pad_2
Thermocouple_Probe
Sampling_Root_Shaft
Sampling_Flight
Bit_Sub_Shoulder
Bit_Sub_Pin_Thread
Joint_Coupling
