tilak-pentapati/Low-Gravity_Rotary-Percussive_Bite-Drilling_System/docs/assets/cad/drill_head.step

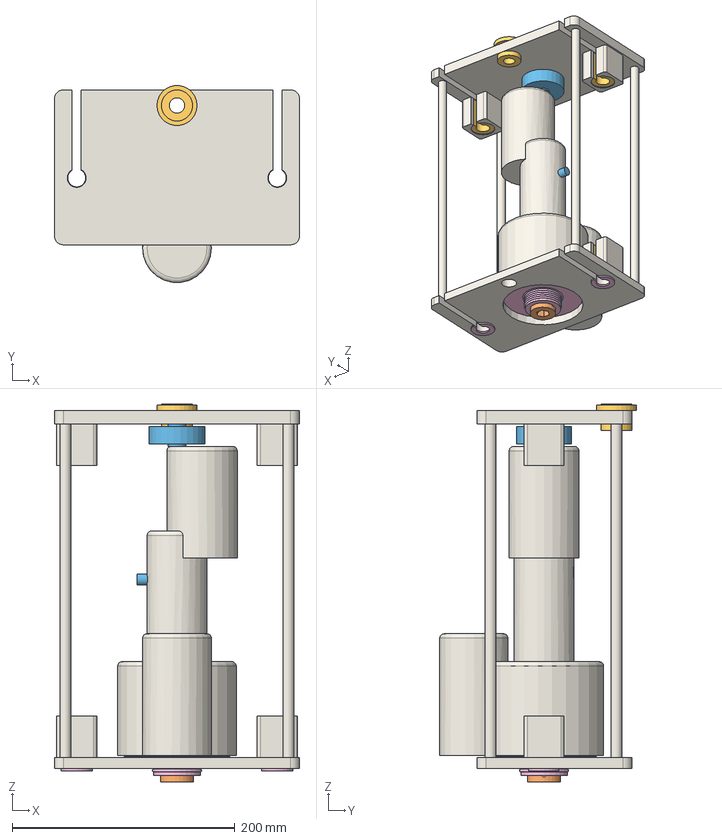
[picture p14: CAD file, 2026-10-22]
docs/assets/cad/drill_head.step
220.0 x 176.6 x 339.2 mm
Cam_Bearing_61812_Rings
Cam_Bearing_Spigot
Percussive_Pinion_18T
Percussive_BLDC_Stator
Percussive_BLDC_End_Turns
Percussive_BLDC_PM_Rotor
Percussive_BLDC_Shaft
Percussive_Encoder_Disc
Spindle_Bearing_7004ACD_A_Rings
Spindle_Bearing_7004ACD_B_Rings
Upper_Bearing_61804_Rings
Slip_Ring_Stator
Slip_Ring_Brush_Block
Primary_Pinion_12T
Planetary_Ring_Gear_84T
Planetary_Sun_12T
Planet_Gear_36T_1
Planet_Gear_36T_2
Planet_Gear_36T_3
Planet_Carrier_Output
Planetary_Cover
Rotary_BLDC_Stator
Rotary_BLDC_End_Turns
Rotary_BLDC_PM_Rotor
Rotary_BLDC_Shaft
Rotary_Encoder_Disc
Head_Housing_Ti
Slip_Ring_Cable_Gland
Spindle_Bearing_Bulkhead
Labyrinth_Seal_Cartridge
PTFE_Lip_Seal
Dust_Cap_PTFE_Lip
Dust_Bellows
Diaphragm_Flexure
Carriage_Base_Plate
Carriage_Top_Yoke
Carriage_Tie_Rod_00
Carriage_Tie_Rod_01
Carriage_Tie_Rod_10
Carriage_Tie_Rod_11
Linear_Bearing_Block_L_Lower
LM16UU_OP_L_Lower
Linear_Bearing_Block_L_Upper
LM16UU_OP_L_Upper
Rail_Wiper_L
Linear_Bearing_Block_R_Lower
LM16UU_OP_R_Lower
Linear_Bearing_Block_R_Upper
LM16UU_OP_R_Upper
Rail_Wiper_R
Leadscrew_Nut_Tr16x4_Bronze
WOB_Load_Cell_500N
Splined_Hollow_Spindle
Spindle_Gear_24T
Slip_Ring_Rotor
Anvil
Hammer_Compression_Spring
Hammer_Mass
Cam_Follower_Stud_1
Cam_Follower_Roller_1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
