tilak-pentapati/Low-Gravity_Rotary-Percussive_Bite-Drilling_System/docs/assets/cad/power_system.step

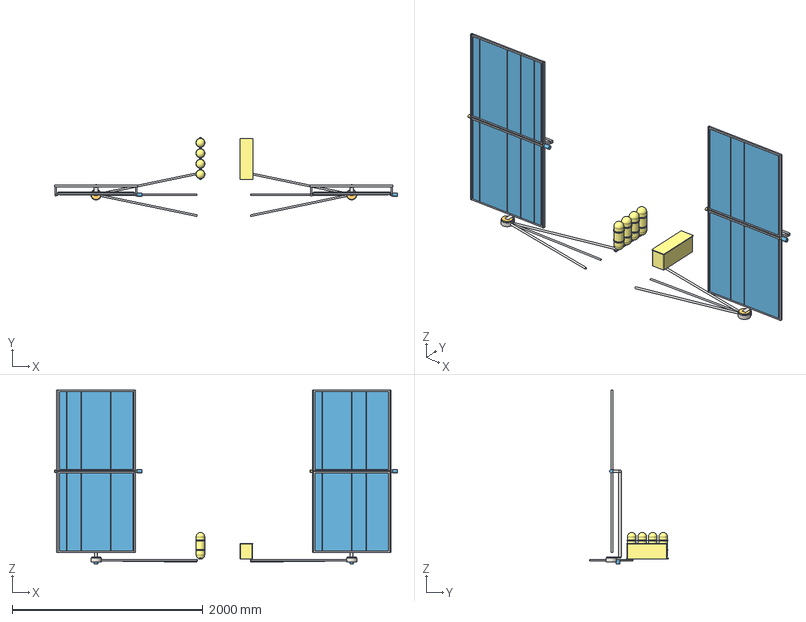
[picture p15: CAD file, 2026-10-22]
docs/assets/cad/power_system.step
3593.3 x 827.8 x 1822.0 mm
H2O2_Reactant_Tank_1
Tank_1_Clamp_1
Tank_1_Clamp_2
H2O2_Reactant_Tank_2
Tank_2_Clamp_1
Tank_2_Clamp_2
H2O2_Reactant_Tank_3
Tank_3_Clamp_1
Tank_3_Clamp_2
H2O2_Reactant_Tank_4
Tank_4_Clamp_1
Tank_4_Clamp_2
Tank_Saddle_Rail
Avionics_WarmBox
Avionics_Radiator
Port_Outrigger_Beam_1
Port_Outrigger_Beam_2
Port_Outrigger_Diagonal
Port_Turntable_Housing
Port_Azimuth_Motor
Starboard_Outrigger_Beam_1
Starboard_Outrigger_Beam_2
Starboard_Outrigger_Diagonal
Starboard_Turntable_Housing
Starboard_Azimuth_Motor
Port_Azimuth_Platter
Port_Mast_Post
Port_Post_Foot
Port_Yoke_Crossbar
Port_Yoke_Arm_1
Port_Elevation_Bearing_1
Port_Yoke_Arm_2
Port_Elevation_Bearing_2
Port_Elevation_Motor
Port_Panel_Upper_Substrate
Port_Panel_Upper_GaInP_Cells
Port_Panel_Upper_Busbar_1
Port_Panel_Upper_Busbar_2
Port_Panel_Upper_Busbar_3
Port_Panel_Upper_Busbar_4
Port_Panel_Upper_Busbar_5
Port_Panel_Lower_Substrate
Port_Panel_Lower_GaInP_Cells
Port_Panel_Lower_Busbar_1
Port_Panel_Lower_Busbar_2
Port_Panel_Lower_Busbar_3
Port_Panel_Lower_Busbar_4
Port_Panel_Lower_Busbar_5
Port_Wing_Side_Frame_1
Port_Elevation_Pin_1
Port_Wing_Side_Frame_2
Port_Elevation_Pin_2
Port_Wing_Back_Spar
Starboard_Azimuth_Platter
Starboard_Mast_Post
Starboard_Post_Foot
Starboard_Yoke_Crossbar
Starboard_Yoke_Arm_1
Starboard_Elevation_Bearing_1
Starboard_Yoke_Arm_2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
