tilak-pentapati/Low-Gravity_Rotary-Percussive_Bite-Drilling_System/docs/assets/cad/brush_station_exploded.step

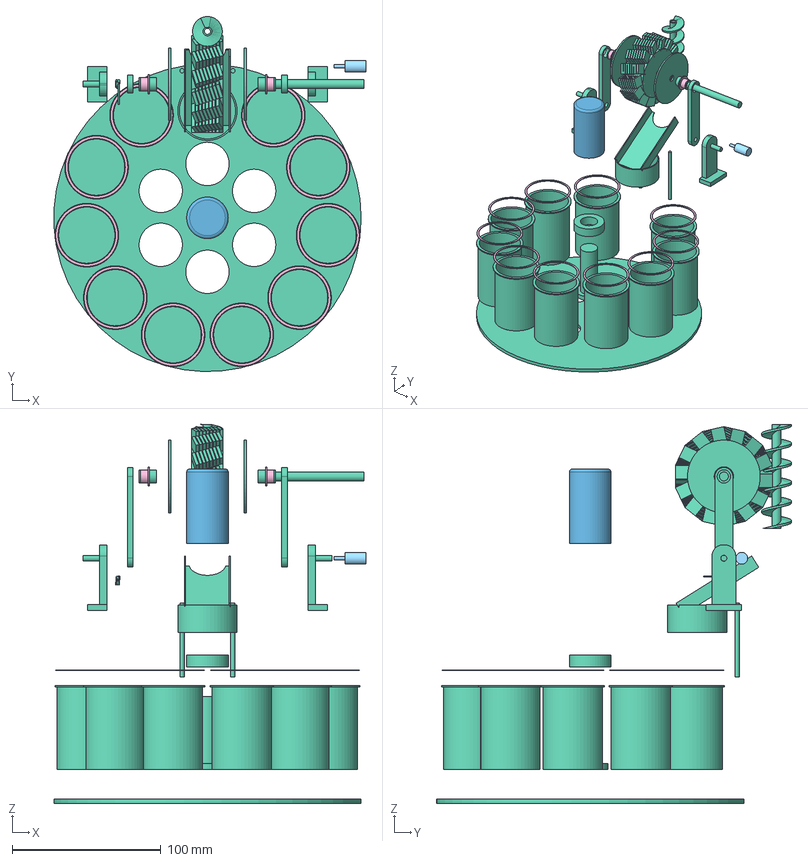
[picture p16: CAD file, 2026-10-22]
docs/assets/cad/brush_station_exploded.step
209.8 x 238.7 x 255.0 mm
Brush_Arm_L
Brush_Axle_Bushing_L
Brush_Pivot_Pin_L
Brush_Pivot_Bracket_L
Brush_Arm_R
Brush_Axle_Bushing_R
Brush_Pivot_Pin_R
Brush_Pivot_Bracket_R
Brush_Torsion_Spring
Stow_Launch_Lock
Sample_Transfer_Chute
Chute_Post_1
Chute_Post_2
Sample_Port_Funnel
Carousel_Index_Motor
Carousel_Hub_Bearing
Brush_Axle
Brush_Hub
Bristle_Tuft_01
Bristle_Tuft_02
Bristle_Tuft_03
Bristle_Tuft_04
Bristle_Tuft_05
Bristle_Tuft_06
Bristle_Tuft_07
Bristle_Tuft_08
Bristle_Tuft_09
Bristle_Tuft_10
Bristle_Tuft_11
Bristle_Tuft_12
Bristle_Tuft_13
Bristle_Tuft_14
Brush_Hub_End_Cap_L
Brush_Axle_Spacer_L
Brush_Hub_End_Cap_R
Brush_Axle_Spacer_R
Carousel_Turntable
Carousel_Hub
Sample_Cup_01
Cup_Seal_Ring_01
Sample_Cup_02
Cup_Seal_Ring_02
Sample_Cup_03
Cup_Seal_Ring_03
Sample_Cup_04
Cup_Seal_Ring_04
Sample_Cup_05
Cup_Seal_Ring_05
Sample_Cup_06
Cup_Seal_Ring_06
Sample_Cup_07
Cup_Seal_Ring_07
Sample_Cup_08
Cup_Seal_Ring_08
Sample_Cup_09
Cup_Seal_Ring_09
Sample_Cup_10
Cup_Seal_Ring_10
Mesh_Context_Sampling_Root_Shaft
Mesh_Context_Sampling_Flight
