tilak-pentapati/Low-Gravity_Rotary-Percussive_Bite-Drilling_System/(list of files, cad)

Other CAD files:
docs/assets/cad/auger_bit.stl
docs/assets/cad/brush_station_exploded.stl
docs/assets/cad/drill_bit_crown.stl
docs/assets/cad/drill_bit_exploded.stl
docs/assets/cad/drill_head.stl
docs/assets/cad/drill_head_section.stl
docs/assets/cad/full_drill_rig.stl
docs/assets/cad/mast_and_brush.stl
docs/assets/cad/mast_stowed.stl
docs/assets/cad/power_system.stl
